ultralaserdeluxe/gloria/dokumentation/designspecifikation/tex/designspecifikation-kopplingsschema-sensorenhet.tex

\section{Kopplingsschema över sensorenhet}

\begin{figure}[h]
\center
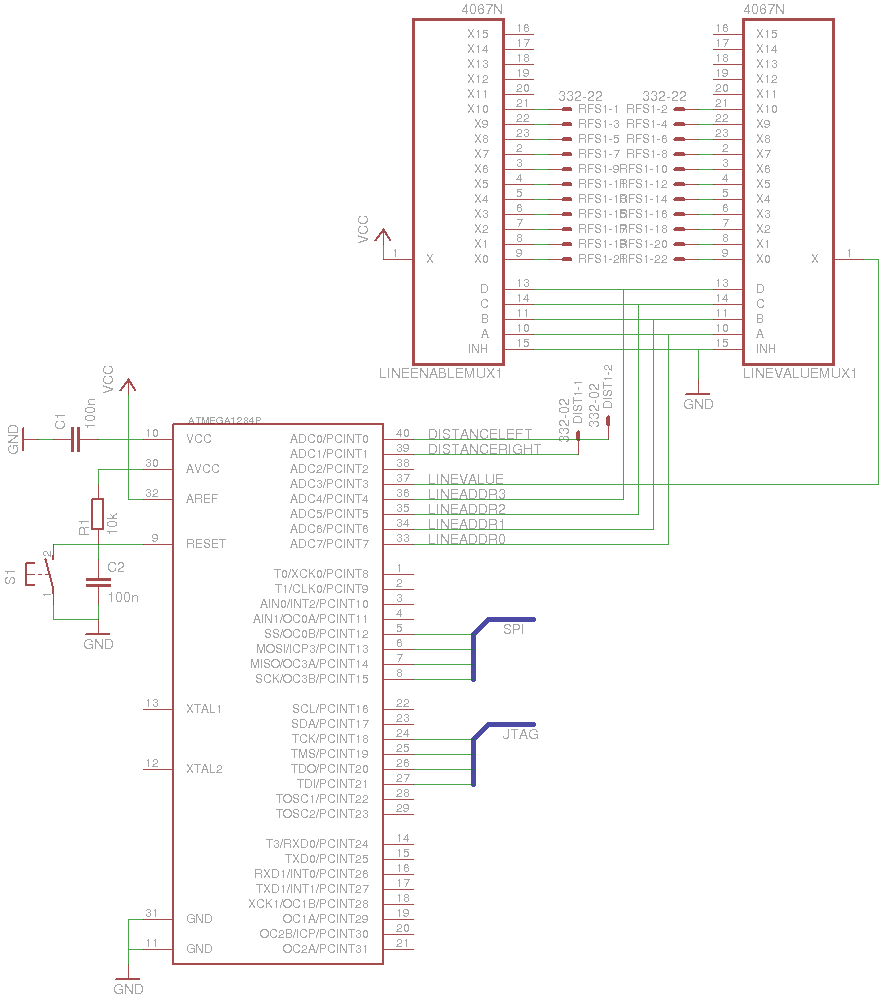
[picture p2: dokumentation/designspecifikation/grafik/kopplingsschema-sensorenhet.png]

\caption{Kopplingsschema över sensorenhet}
\end{figure}

Signalerna RFS går till reflexsensormodulen. Jämna nummer är utsignaler från fototransistorerna. Udda är enablesignaler till lysdioderna. DISTANCELEFT och DISTANCERIGHT är utsignalerna från avståndssensorerna. LINEADDR-signalerna kontrollerar vilken lysdiod i reflexsensormodulen som är aktiv. SPI-bussen ansluts till huvudenheten. JTAG-bussen kopplas till JTAG ICE-3.
