ultralaserdeluxe/gloria/dokumentation/designspecifikation/tex/designspecifikation-kopplingsschema-styrenhet.tex

\section{Kopplingsschema över styrenhet}

\begin{figure}[h]
\center
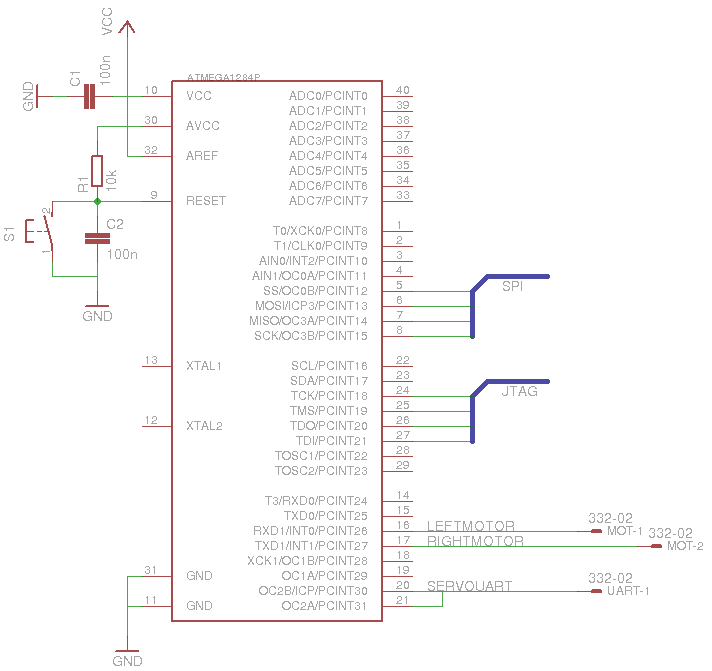
[picture p3: dokumentation/designspecifikation/grafik/kopplingsschema-styrenhet.png]

\caption{Kopplingsschema över styrenhet}
\end{figure}

LEFTMOTOR och RIGHTMOTOR kopplas till motorernas styrportar. SERVOUART kopplas till DATA-porten på armens första servo. SPI-bussen ansluts till huvudenheten. JTAG-bussen kopplas till JTAG ICE-3.
