ultralaserdeluxe/gloria/dokumentation/designspecifikation/tex/designspecifikation-sensorenhet.tex

%\documentclass[a4paper,11pt]{article}
%\usepackage[a4paper]{}
%\usepackage[utf8]{inputenc}
%\usepackage{listings}
%\usepackage{graphicx}
%\begin{document}

\section{Sensorenhet}
Sensorenheten har till uppgift att läsa in data från robotens sensorer, tolka den och vidarebefodra den till huvudenheten. En reflexsensormodul används för att roboten skall kunna hålla sig på banan. För att kunna detektera paket kommer roboten ha en avståndssensor på vardera sida. \\

\begin{figure}[h]
\center
\scalebox{0.9}{\input{grafik/sensorenhet-blockschema.tex}}
\caption{Blockschema över sensorenheten}
\end{figure}

\subsection{Reflexsensormodul}
Reflexsensormodulen består av 11 reflexsensorer. En reflexsensor består av en lysdiod och en fototransistor. Fototransistorn har ett analogt utvärde mellan 0 och 5V beroende på hur mycket ljus som fångas upp. Genom att sätta enable för en lysdiod till 1 och sedan läsa av den tillhörande fototransistorn kan vi avgöra om underlaget är ljust eller mörkt. Fototransistorn läses av med en AD-omvandling på AVRen. Detta görs för varje reflexsensor och på så sätt kan vi detektera tejpens position under sensorn eftersom tejpen banan består av får förutsättas ha en annan färg än golvet. Eftersom AVRen har ett begränsat antal pinnar med AD-omvandling, muxar vi fototransistorernas utgångar till en enda pinne på AVRen. Då vi inte vill ha mer än en lysdiod igång samtidigt kommer vi använda ytterligare en mux för att styra en enablesignal till den lysdiod vi vill använda, övriga kommer vara avslagna.

\subsubsection{Kalibrering}
Beroende på vilket underlag roboten arbetar på kommer värdena för golv och tejp att variera. Vi behöver därför kunna kalibrera sensorn för att sätta standardvärden. Detta kommer ske på ett sådant sätt att vi först låter roboten titta på bara golvet och sedan en bit tejp. Vi sparar de värden vi får under dessa testfall och använder dem som referens när vi ska detektera golv eller tejp.

\subsection{Avståndssensor}
För att kunna detektera paket kommer roboten ha en avståndssensor på höger respektive vänster sida. Dessa kommer vara av typen GP2D120 och använder IR för att generera en analog signal. Denna signal läses av med en AD-omvandling på AVRen. Då sensorns utsignal är olinjär kommer vi under utveckligsfasen ta fram en tabell med närmevärden för olika distanser. Utsignalen jämförs med denna tabell för att estimera det uppmätta avståndet till ett föremål.

\subsection{Mjukvara}
Sensorenheten kör kontinuerligt en loop där den läser och lagrar data från sensorerna. Då huvudenheten skickar en instruktion till sensorenheten körs en avbrottsrutin där instruktionen tolkas och utförs. Antingen kalibreras sensorerna eller så returnerar sensorenheten data för den adresserade sensorn.

\subsection{Komponenter}
Följande komponenter är nödvändiga för konstruktion av sensorenheten. \\

\begin{tabularx}{\textwidth}{| l | X |}
	\hline
	{\textbf{Komponent}} & {\textbf{Tillgänglighet}} \\\hline
	{En AVR av typ Atmega1284} & {Tillgänglig} \\\hline
	{En JTAG Ice 3} & {Tillgänglig} \\\hline
	{En Reflexsensormodul} & {Tillgänglig} \\\hline
	{Två muxar av typ MC14067B} & {Tillgängliga} \\\hline
	{Två avsåndssensorer av typ GP2D120} & {Tillgängliga} \\\hline
	{En avstudsad tryckknapp} & {Tillgänglig} \\\hline
\end{tabularx}
