ultralaserdeluxe/gloria/dokumentation/designspecifikation/tex/designspecifikation-styrenhet.tex

\section{Styrenhet}
Styrenheten har till uppgift att driva de motorer som driver hjulen och de servon som styr armen. Styrenheten består av en AVR av typ Atmega1284, två motorpar och en robotarm av typ Trossenrobotics Reactor\cite{trossenarm}. AVRen är ansluten till huvudenheten med en SPI-buss och en busy-pinne. Instruktioner från huvudenheten fås enligt protokoll definierat i sektion \ref{protokoll:pc-motor}.

\begin{figure}[H]
\center
\input{grafik/styrenhet-blockschema.tex}
\caption{Blockschema över styrenheten}
\end{figure}

\subsection{Framdrivning}

Styrenheten innehåller två motorpar. De är anslutna med två PWM-signaler till AVRen, en till höger respektive vänster hjulpar. Från huvudenheten får styrenheten önskad hastighet på vardera hjulpar, vilka den applicerar och har så möjlighet att styra roboten framåt, bakåt, höger och vänster. Styrenheten är ansvarig för att i mjukvara implementera acceleration av motorerna så att roboten rör sig med jämna och mjuka rörelser.

\subsection{Robotarm}

Robotarmen består av 7 servon av modell AX12-A\cite{servo}. De är anslutna till AVRen med en UART-buss. Dessa servon styrs genom att en målvinkel sätts (0-1023) med möjlighet att ändra hastighet, vridmoment och styra av/på. Från huvudenheten får styrenheten målvinklar för varje enskild led. Styrenheten är ansvarig för att se till att parallella servon körs synkroniserat för att inte slita sönder varandra. Styrenheten är också ansvarig för att servona accelerar och bromsar något i sina rörelser för att robotarmen skall röra sig mjukt och utan ryck. Så länge robotarmen är i rörelse sätts en busy-flagga. Den låter huvudenheten utföra köade instruktioner för robotarmen så snart som det är möjligt.

\subsection{Mjukvara}

Mjukvaran på styrenheten kommer i första hand att vara avbrottsstyrd. Figur \ref{designspec:motor-interrupt-figure} illustrerar programflödet för avbrott. Vid instruktioner för att uppdatera målposition eller hastighet kommer enheten lägga den i en kö. När enheten ombes utföra alla instruktioner kommer den gå igenom kön och uppdatera målpositioner och hastigheter på servon och motorer enligt tidigare inkomna instruktioner. \\
När AVRen inte är upptagen med avbrott körs en loop där alla servons hastighet och position läses av, jämförs med dess målposition och uppdateras med en ny hastighet. Figur \ref{designspec:motor-main-figure} illustrerar programflödet. Detta ger robotarmen jämna och mjuka rörelser. \\

\begin{figure}[H]
\centering
\begin{minipage}[b]{.5\linewidth}
\centering
\scalebox{0.7}{\input{grafik/styrenhet-avbrott-flode}}
\subcaption{Flödesschema för avbrottsrutin}\label{designspec:motor-interrupt-figure}
\end{minipage}%
\begin{minipage}[b]{.5\linewidth}
\centering
\scalebox{0.6}{\input{grafik/styrenhet-main-flode}}
\subcaption{Flödesschema för mainloop}\label{designspec:motor-main-figure}
\end{minipage}
\caption{Styrenhetens mjukvara}\label{fig:1}
\end{figure}

\subsection{Komponenter}
Följande komponenter är nödvändiga för konstruktion av styrenheten. \\
\begin{tabularx}{\textwidth}{| l | X |}
	\hline
	{\textbf{Komponent}} & {\textbf{Tillgänglighet}} \\\hline
	{Två hjulpar} & {Tillgängliga} \\\hline
	{En AVR av typ Atmega1284} & {Tillgänglig} \\\hline
	{En Trossenrobotics Reactor} & {Tillgänglig} \\\hline
	{En JTAG Ice 3} & {Tillgänglig} \\\hline
	{En avstudsad tryckknapp} & {Tillgänglig} \\\hline
\end{tabularx}
