ultralaserdeluxe/gloria/dokumentation/designspecifikation/tex/designspecifikation-referenser.tex

\begin{thebibliography}{9}
\bibitem{handledare} Johansson, Peter, handledare i kursen TSEA29, Linköping, 2014-10-08 (Möte).
\bibitem{nivaomvandlare} \url{http://www.electrokit.com/nivaomvandlare-8-kanaler.50717}, information hämtad 2014-10-13
\bibitem{servo} \url{http://support.robotis.com/en/techsupport_eng.htm#product/dynamixel/ax_series/dxl_ax_actuator.htm}, information hämtad 2014-10-24
\bibitem{trossenarm} \url{http://www.trossenrobotics.com/p/phantomx-ax-12-reactor-robot-arm.aspx}, information hämtad 2014-10-24
\end{thebibliography}
