ultralaserdeluxe/gloria/Dokumentation/Kravspecifikation/Kravspec03.tex

\section{Huvudmodul}

\subsection{Inledande beskrivning av huvudmodul}
Huvudmodulen utför alla nödvändiga beräkningar med data från undermodulerna. Huvudmodulen fattar beslut om någonting ska göras och skickar kommandon til undermodulerna om den är i autonomt läge, är den i manuellt läga fås kommandon från användaren. I båda lägena ska data skickas tillbaka till användaren.

\subsection{Gränssnitt}
\begin{LIPSkravlista}
\LIPSkrav{Orginal}{Huvudmodulen skall kunna skicka och ta emot nödvändiga data från de övriga modulerna}{1}
\end{LIPSkravlista}

\subsection{Funktionella krav för huvudmodul}	
\begin{LIPSkravlista}
\LIPSkrav{Orginal}{Motorer och servon skall regleras smidigt och utan ryck}{1}
\end{LIPSkravlista}
