ultralaserdeluxe/gloria/dokumentation/tekniskdokumentation/tex/tekdok-teori.tex

\section{Teori}
I projektet ingår främst två större teoretiska beräkningsmoment. Vi måste reglera utdatan till motorerna för att roboten skall följa linjen. Vidare vill vi kunna använda enklare koordinater för att tala om vart i rummet armen befinner sig, och vi behöver således kunna konvertera $(x,y,z)$-koordinater till vinklar för armens axlar.

\subsection{Reglering}
För att följa banan måste vi reglera motorernas hastighet. Vi gör detta genom att beräkna ett fel och ändra motorernas hastighet proportionellt mot detta. Felet beräknas genom att vi i varje iteration beräknar vart tejpen befinner sig längs den främre linjesensorn. För att göra detta multiplicerar vi linjesensorvärdena med vikter, dividerar med summan av linjesensorvärdena och subtraherar sedan medianvärdet, vilket i det här fallet är $6$. Vi får ekvation \ref{eq1}.

\begin{equation} \label{eq1}
	Q_{fel}=6-\frac{\sum_{i=1}^{11}S_{n}*n}{\sum_{i=1}^{11}S_n}
\end{equation}

För att beräkna utsignalen använder vi felet $Q_{fel}$ och förändringen jämfört med förra iterationen ${\Delta}Q_{fel}$ tillsammans med konstanterna $P$ och $D$. Vi vet från avsnitt \ref{huvud-regulator} att regleringen körs med en uppdateringsfrekvens på 50Hz.

\begin{equation} \label{eq2}
	Q_{out}=(P*Q_{fel}+D*{\Delta}Q_{fel})*freq
\end{equation}

$Q_{out}$ i ekvationen ovan är den utsignal som används för att beräkna motorernas nya hastigheter.

\subsection{Styrning av arm}
Omvandlingen från $(x,y,z)$-koordinater till vinklar för armens servon sker på huvudenheten. På huvudenheten finns en pythonmodul \texttt{arm.py} som implementerar beräkningarna som beskrivs nedan. Den används i tre steg.
\begin{enumerate}
	\item Skapa en instans av \texttt{robotArm} som är en klass i \texttt{arm.py}.
	\item Använd funktionen \texttt{setAll} som tar in en lista som argument med följande innehåll \newline \texttt{[x,y,z,gripperAngle,gripperRotationsOffset,gripper]}.
	\item Använd funktionen \texttt{getServoValues} som returnerar en lista med alla servons vinklar i form av 10-bitars heltal.
\end{enumerate}

\texttt{GripperAngle} är gripklons vinkel mot marken, \texttt{gripperRotationsOffset} är en offset på gripklons vinkel i förhållande till leden som gripklon är fäst i och \texttt{gripper} är hur mycket gripklon klämmer.

I listan som returneras är första värdet armens bas, det andra är $A1$, det tredje är $A2$, det fjärde $A3$, det femte klons rotation och det sjätte klons grepp.

\begin{figure}[h!]
	\centerline{\input{grafik/huvud-armkoordinatsystem}}
	\caption{Armens koordinatsystem i förhållande till roboten. Upp är robotens färdriktning}
\end{figure}

\begin{figure}[h!]
	\centerline{\input{grafik/huvud-armvinklar}}
	\caption{Armens vinklar}
\end{figure}

Omvandlingen sker på följande sätt där \texttt{gripperRotationOffset} och \texttt{gripper} ignoreras. Antag att roboten startar i $(X,Y,Z,GR)=(0,0,0,\pi/2)$.
Där $GR$(GripRadian) är vilken vinkel gripklon har till $z$-axeln.\newline
Vi omvandlar våra rum-koordinater till en vinkel och plankoordinater $X,Y,Z,GR\rightarrow A,W,Z,GR$. Där $A$ är armens vinkel mot positiva $x$-axeln och $W$ är armens utsträckning.
$$A=tan^{-1}(\dfrac{Y}{X}) $$
$$W=\sqrt{X^2+Y^2}$$
Genom denna omvandlingen så kan vi göra om detta till ett 2-dimensionellt problem istället för ett 3-dimensionellt problem. Vi får in $X$,$Y$,$Z$,$GR$ och ställer in robotens vinkel mot $x$-axelns positiva del och sedan ser vi till att roboten bara har rätt utsträckning och höjd.
$$P_4=(W,Z)$$
$$P_0=(0,0)$$
$$W_2=W-cos(GR)*L_3$$
$$Z_2=Z-sin(GR)*L_3$$
$$H_L=\sqrt{W_2^2+Z_2^2}$$
$$H_A=tan^{-1}(\dfrac{Z_2}{W_2})$$
Cosinussatsen ger:
$$A_1=cos^{-1}(\dfrac{L_1^2+H_L^2-L_2^2}{2*L_1*H_L})+H_A$$
$$W_1=cos(A_1)*L_1$$
$$Z_1=sin(A_1)*L_1$$
$$A_2=tan^{-1}(\dfrac{Z_2-Z_1}{W_2-W_1})-A_1$$
$$A_3=GR-D_2-D_3$$

Då är alla vinklar beräknade men servornas nollpunkter är inte på samma ställen som nollställena i beräkningarna ovanför. Så följande offset ställs in i grader:

\begin{itemize}
	\item $A0=A0+60$
	\item $A1=240-A1$
	\item $A2=240-A2$
	\item $A3=150-A3$
	\item $A4=240-A0+$\texttt{GripperRotationOffset} (klons rotation beror på basens rotation)
	\item $A5$ har ingen offset
\end{itemize}

Dessa vinklar är nu i grader. Dessa multipliceras nu med $\frac{1024}{360}$ för att omvandla grader till 10-bitars binära tal, dessa avrundas nedåt till heltal och kan nu användas direkt av styrenheten.
