ultralaserdeluxe/gloria/dokumentation/tekniskdokumentation/tex/tekdok-kopplingsschema.tex

\section{Kopplingsschema} \label{kopplingsschema}

På nästkommande sidor följer de kopplingsscheman som beskriver hur hårdvaran i Gloria hänger ihop.

\begin{figure}[h!]
	\centering
	
	\caption{Kopplingsschema styrenhet} \label{kopplingsschema-styrenhet}
\end{figure}

\begin{figure}[h!]
	\centering
	
	\caption{Kopplingsschema sensorenhet} \label{kopplingsschema-sensor}
\end{figure}

\begin{figure}[h!]
	\centering
	
	\caption{Kopplingsschema level-shifters och reset-knapp} \label{kopplingsschema-levelshifter}
\end{figure}

\begin{figure}[h!]
	\centering
	
	\caption{Hur PCBn ser ut} \label{kopplingsschema-pcb}
\end{figure}
