ultralaserdeluxe/gloria/dokumentation/motesprotokoll/tex/protokoll_20141215.tex

\documentclass[titlepage, a4paper]{article}
\input{../../mall/layout.tex}	% Importera generella layout-strukturer
\usepackage{tabularx}

\newcommand{\LIPSdokumenttyp}{Mötesprotokoll}
\newcommand{\LIPSkursnamn}{TSEA29}
\newcommand{\LIPSprojektnamn}{Lagerrobot}
\newcommand{\LIPSprojektgrupp}{Grupp 2}
\newcommand{\LIPSutfardare}{hansn314} % Vem har utfärdat protokollet?

\pagenumbering{roman}	% Sidnumrering

\begin{document}

	\begin{projektmote}{Mötesprotokoll}{2014-12-15}
		% ------------ PARAGRAFER ----------------------
		% Syntax \paragraf{Vi bestämde och kom överens}
		% ----------------------------------------------
		\paragraf{Mötet öppnas.}
		\paragraf{Hannes för protokoll.}
		\paragraf{Närvarande: Martin, Daniel, Dennis, Pål, Yngve och Hannes.}
		\paragraf{Vi går igenom vad som saknas. Främst arm-relaterat såsom smidigare rörelse av arm och nedsättning av paket.}
		\paragraf{Mötet avslutas.}
	\end{projektmote}

	\newpage
	\begin{center}
		\begin{tabularx}{\textwidth}{| p{4mm} | X | p{13.5mm} | X |}
			\hline
			\textbf{Nr} & \textbf{Aktivitet} & \textbf{Ansvar} & \textbf{Status} \\\hline
			% ------------ Aktuella aktiviteter ------------
			% Syntax {Nr} & {Aktivitet} & {Ansvarig} & {Status} \\\hline
			% ----------------------------------------------
			{14} & {Skriva UI för PC} & {DW,MS} & {Martin har börjat skriva ett nytt} \\\hline
			{24} & {Implementera styrlogik} & {DL} & {Klar} \\\hline
			{26} & {Mäta respons från motorer och servon} & {AY} & {Klar} \\\hline
			{35} & {Implementera läsning av sensordata på huvud} & {DL} & {Klar} \\\hline
			{40} & {Implementera smoothing-funktion för servon och motorer} & {DL} & {Ej påbörjad} \\\hline
			{41} & {Implementera paketnedsättningsfunktion} & {PK} & {Påbörjad} \\\hline
			{42} & {Implementera fjärrstyrning från PC} & {DW} & {Klar} \\\hline
			{43} & {Implementera detektion av stoppmarkering} & {} & {Klar} \\\hline
			{44} & {Implementera detektion av paket} & {} & {Klar} \\\hline
			{45} & {Implementera detektion av stationer} & {} & {Klar} \\\hline
			{46} & {Implementera regleringsalgoritm} & {AY, MS} & {Implementerad och fungerar bra, behöver finjusteras} \\\hline
			{49} & {Dokumentation: Teknisk dokumentation} & {HS} & {Påbörjad} \\\hline
			{54} & {Tejpa testbanor} & {DW} & {Klar} \\\hline
		\end{tabularx}
	\end{center}

\end{document}
