ultralaserdeluxe/gloria/dokumentation/kravspecifikation/tex/kravspecifikation-programvara.tex

\section{Programvara för PC}

\subsection{Inledande beskrivning av programvara för PC}
Programvaran skall köras på en PC för att göra det möjligt att styra roboten och visa sensor- och debugdata.

\subsection{Gränssnitt}
\begin{LIPSkravlista}
\LIPSkrav{2014-09-12}{Datorn skall kommunicera trådlöst med roboten}{1}
\end{LIPSkravlista}

\subsection{Funktionella krav på programvara för PC}
\begin{LIPSkravlista}
\LIPSkrav{2014-09-12}{Datorn skall kunna skicka följande kommandon: fram, fram vänster, fram höger, back, stopp och kalibrering}{1}
\LIPSkrav{2014-12-08}{Datorn skall kunna skicka kommandon för att styra armens samtliga servon}{1}
\LIPSkrav{Orginal}{Programvaran skall visa sensor- och debugdata}{1}
\end{LIPSkravlista}
