ultralaserdeluxe/gloria/dokumentation/kravspecifikation/tex/kravspecifikation-sensormodul.tex

\section{Sensormodul}
\subsection{Inledande beskrivning av sensormodul}
Sensormodulen skall sköta sensordata för linjeföljare, avståndsmätare för detektering av objekt samt eventuella andra sensorer som kan behövas.

\subsection{Gränssnitt}
\begin{LIPSkravlista}
\LIPSkrav{2014-09-12}{Sensormodulen skall ta emot kommandon från huvudmodulen}{1}
\LIPSkrav{2014-09-12}{Sensormodulen skall skicka sensordata till huvudmodulen}{1}
\end{LIPSkravlista}

\subsection{Funktionella krav för sensormodul}
\begin{LIPSkravlista}
\addtocounter{LIPSkravnummer}{1} % Hade krav
\LIPSkrav{Orginal}{Sensorer skall kunna detektera banan}{1}
\LIPSkrav{2014-09-16}{Sensorer skall kunna detektera ett paket}{1}
\LIPSkrav{Orginal}{Sensorer skall kunna identifiera RFID}{2}
\end{LIPSkravlista}
