ultralaserdeluxe/gloria/dokumentation/kravspecifikation/tex/kravspecifikation-styrmodul.tex

\section{Styrmodul}

\subsection{Inledande beskrivning av motormodul}
Styrmodulen skall sköta framdrivningen av roboten samt sköta de servon som styr robotarmen.

\subsection{Gränssnitt}
\begin{LIPSkravlista}
\LIPSkrav{2014-09-12}{Styrmodulen skall ta emot kommandon från huvudmodulen}{1}
\end{LIPSkravlista}

\subsection{Funktionella krav för styrmodul}
\begin{LIPSkravlista}
\LIPSkrav{Orginal}{Styrmodulen skall utföra kommandon från huvudmodulen}{1}
\LIPSkrav{2014-12-08}{Styrmodulen skall justera hjulens hastighet}{1}
\LIPSkrav{Orginal}{Styrmodulen skall reglera hjulens hastighet utifrån sensordata}{2}
\LIPSkrav{2014-09-12}{Styrmodulen skall reglera de servon som styr armen}{1}
\LIPSkrav{Orginal}{Armrörelser skall ske utan uppenbara ryck}{1}
\LIPSkrav{2014-09-12}{Armen skall återgå till ett förutbestämt läge vid ett särskilt givet kommando}{2}
\end{LIPSkravlista}
