ultralaserdeluxe/gloria/dokumentation/motesprotokoll/tex/protokoll_20141208.tex

\documentclass[titlepage, a4paper]{article}
\input{../mall/layout.tex}	% Importera generella layout-strukturer
\usepackage{tabularx}

\newcommand{\LIPSdokumenttyp}{Mötesprotokoll}
\newcommand{\LIPSkursnamn}{TSEA29}
\newcommand{\LIPSprojektnamn}{Lagerrobot}
\newcommand{\LIPSprojektgrupp}{Grupp 2}
\newcommand{\LIPSutfardare}{hansn314} % Vem har utfärdat protokollet?

\pagenumbering{roman}	% Sidnumrering

\begin{document}

	\begin{projektmote}{Mötesprotokoll}{2014-12-08}
		% ------------ PARAGRAFER ----------------------
		% Syntax \paragraf{Vi bestämde och kom överens}
		% ----------------------------------------------
		\paragraf{Mötet öppnas.}
		\paragraf{Hannes för protokoll.}
		\paragraf{Närvarande: Martin, Daniel, Dennis, Pål, Yngve och Hannes.}
		\paragraf{Vi går igenom tidsplanen.}
		\paragraf{Vi diskuterar vad som fungerar, vad som inte fungerar och vad som bör göras i veckan.
		\begin{itemize}
			\item{Fixa haspackage-flagga}
			\item{Testa styrlogik}
			\item{Integrera joystick i GUI}
			\item{Merga alla brancher}
		\end{itemize}
		}
		\paragraf{Mötet avslutas.}
	\end{projektmote}

	\newpage
	\begin{center}
		\begin{tabularx}{\textwidth}{| p{4mm} | X | p{13.5mm} | X |}
			\hline
			\textbf{Nr} & \textbf{Aktivitet} & \textbf{Ansvar} & \textbf{Status} \\\hline
			% ------------ Aktuella aktiviteter ------------
			% Syntax {Nr} & {Aktivitet} & {Ansvarig} & {Status} \\\hline
			% ----------------------------------------------
			{14} & {Skriva UI för PC} & {DW} & {En första iteration färdig} \\\hline
			{24} & {Implementera styrlogik} & {DL} & {Påbörjad} \\\hline
			{26} & {Mäta respons från motorer och servon} & {AY} & {Påbörjad} \\\hline
			{28} & {Tolka IR-sensordata} & {PK} & {Påbörjad} \\\hline
			{35} & {Implementera läsning av sensordata på huvud} & {DL} & {Påbörjad} \\\hline
			{40} & {Implementera smoothing-funktion för servon och motorer} & {DL} & {Ej påbörjad} \\\hline
			{41} & {Implementera paketnedsättningsfunktion} & {PK} & {Ej påbörjad, försenad} \\\hline
			{42} & {Implementera fjärrstyrning från PC} & {DW} & {Påbörjad} \\\hline
			{43} & {Implementera detektion av stoppmarkering} & {} & {påbörjad} \\\hline
			{44} & {Implementera detektion av paket} & {} & {Påbörjad} \\\hline
			{45} & {Implementera detektion av stationer} & {} & {Påbörjad} \\\hline
			{46} & {Implementera regleringsalgoritm} & {AY, MS} & {Implementerad och fungerar bra, behöver finjusteras} \\\hline
			{49} & {Dokumentation: Teknisk dokumentation} & {HS} & {Påbörjad} \\\hline
			{54} & {Tejpa testbanor} & {DW} & {Klar} \\\hline
		\end{tabularx}
	\end{center}

\end{document}
