ultralaserdeluxe/gloria/dokumentation/kravspecifikation/tex/kravspecifikation-huvudmodul.tex

\section{Huvudmodul}

\subsection{Inledande beskrivning av huvudmodul}
Huvudmodulen skall utföra beräkningar nödvändiga för robotens funktion. Huvudmodulen fattar beslut om någonting skall göras och skickar kommandon till undermodulerna om den är i autonomt läge, är den i manuellt läge fås kommandon från användaren. I båda lägena skall data skickas tillbaka till användaren.

\subsection{Gränssnitt}
\begin{LIPSkravlista}
\LIPSkrav{2014-09-12}{Huvudmodulen skall skicka kommandon till sensormodulen}{1}
\LIPSkrav{2014-09-12}{Huvudmodulen skall ta emot sensordata från sensormodulen}{1}
\LIPSkrav{2014-09-12}{Huvudmodulen skall skicka kommandon till styrmodulen}{1}
\LIPSkrav{2014-09-12}{Huvudmodulen skall skicka sensordata och driftinformation till datorn}{1}
\LIPSkrav{2014-09-12}{Huvudmodulen skall ta emot kommandon från datorn}{1}
\end{LIPSkravlista}

\subsection{Funktionella krav för huvudmodul}	
\begin{LIPSkravlista}
\LIPSkrav{Orginal}{Motorer och servon skall regleras smidigt och utan ryck}{1}
\LIPSkrav{Orginal}{Roboten skall följa banan utan att sick-sacka sig fram}{1}
\end{LIPSkravlista}
