ultralaserdeluxe/gloria/dokumentation/kravspecifikation/tex/kravspecifikation-kommunikationsmodul.tex

\section{Kommunikationsmodul}

\subsection{Inledande beskrivning av kommunikationsmodul}
Kommunikationsmodulen är länken som gör kommunikation mellan huvudmodulen och PCn möjlig.

\subsection{Gränssnitt}
\begin{LIPSkravlista}
\LIPSkrav{2014-09-12}{Kommunikationsmodulen skall ta emot kommandon från PC-mmodulen}{1}
\LIPSkrav{2014-09-12}{Kommunikationsmodulen skall skicka kommandon till huvudmodulen}{1}
\LIPSkrav{2014-09-12}{Kommunikationsmodulen skall ta emot sensordata och driftinformation från huvudmodulen}{1}
\LIPSkrav{2014-09-12}{Kommunikationsmodulen skall skicka sensordata och driftinformation till PC-modulen}{1}
\end{LIPSkravlista}
