ultralaserdeluxe/gloria/dokumentation/kravspecifikation/tex/kravspecifikation-motormodul.tex

\section{Motormodul}

\subsection{Inledande beskrivning av motormodul}
Motormodulen sköter framdrivningen av roboten.

\subsection{Gränssnitt}
\begin{LIPSkravlista}
\LIPSkrav{2014-09-12}{Motormodulen skall ta emot kommandon från huvudmodulen}{1}
\end{LIPSkravlista}

\subsection{Funktionella krav för motormodul}
\begin{LIPSkravlista}
\LIPSkrav{Orginal}{Motormodulen skall reglera hjulens hastighet}{1}
\LIPSkrav{Orginal}{Motormodulen skall utföra kommandon från huvudmodulen}{1}
\LIPSkrav{Orginal}{Motormodulen skall reglera hjulens hastighet utifrån sensordata}{2}
\end{LIPSkravlista}
