ultralaserdeluxe/gloria/dokumentation/motesprotokoll/protokoll_20141201.pdf

Utfärdat av hansn314
2 december 2014

# Mötesprotokoll

2014-12-01

- §1. Mötet öppnas.
- §2. Närvarande: Martin, Daniel, Dennis, Pål, Yngve och Hannes
- §3. Vi går igenom bordlagda frågor angående statusrapporten:

– Hur mycket tid har ni kvar av era budgeterade timmar?
Vi har 354 budgeterade timmar kvar att lägga på projektet.

– Hur många timmar har respektive projektmedlem kvar att leverera och hur ska dessa timmar fördelas över de kvarvarande veckorna? Redovisa i en tabell i statusrapporten hur många timmar detta blir per person och vecka. Redovisa också vilka aktiviteter som respektive person ska arbeta med.

Vem | Sammanlagt | v.49 | v.50 | v.51 | Aktiviteter
Pål | 63 | 25 | 25 | 13 | 48,41,44,53,50,42
Hannes | 46 | 18 | 18 | 10 | 48,49,26,45
Martin | 55 | 20 | 20 | 15 | 48,38,39,46,53
Dennis | 72 | 27 | 27 | 18 | 48,24,40,44,47,53
Yngve | 53 | 20 | 20 | 13 | 48,46,43,49
Daniel | 67 | 25 | 25 | 17 | 48,47,42,51,52
- §4. Mötet avslutas.

TSEA29
Mötesprotokoll
i | Grupp 2 Lagerrobot

Utfärdat av hansn314
2 december 2014

## Aktuella aktiviteter

Nr | Aktivitet | Ansvar | Status
14 | Skriva UI för PC | DW | En första iteration färdig
17 | Implementera styrning av servon | HS | Klarr
24 | Implementera styrlogik | DL | Påbörjad
26 | Mäta respons från motorer och servon | AY | Ej påbörjad, Försenad
28 | Tolka IR-sensordata | PK | Påbörjad
33 | Testa styra servon från huvud | AY | Klar
35 | Implementera läsning av sensordata på huvud | DL | Påbörjad
38 | Implementera och testa X,Y,Z till ser-vovinkel konvertering | MS, HS | Ej testat, annars klart
39 | Implementera och testa gränser för armen | MS | Ej påbörjad, försenad
40 | Implementera smoothing-funktion för servon och motorer | DL | Ej påbörjad
41 | Implementera paket-nedsättningsfunktion | PK | Ej påbörjad, försenad
42 | Implementera fjärrstyrning från PC | DW | Påbörjad
43 | Implementera detektion av stoppmar-kering | | påbörjad
44 | Implementera detektion av paket | | Påbörjad
45 | Implementera detektion av stationer | | Påbörjad
46 | Implementera regleringsalgoritm | AY, MS | Implementerad, behöver finjusteras
54 | Tejpa testbanor | DW | Ej påbörjad

TSEA29
Mötesprotokoll
ii | Grupp 2 Lagerrobot
