ultralaserdeluxe/gloria/dokumentation/tidsplan/tidsplan_v1.0.pdf

Projekt: | Lagerrobot
Projektgrupp: | 2 | Datum: | 2014-10-02 | Granskad:
Beställare: | Tomas Svensson | Version: | 1,0
Kurs: | Konstruktion med mikrodatorer TSEA29 | Utfärdare: | Tomas Svensson
AKTIVITETER | TID | VEM | TIDPLAN (när), veckonummer | SUMMA
Nr | Beskrivning | Beroenden | timmar | Initialer | 40 | 41 | 42 | 43 | 44 | 45 | 46 | 47 | 48 | 49 | 50 | 51
1 | Implementera buss mellan huvud och styr | | 16 | AY,DL | | | | Tentaperiod | Tentaperiod | 16 | | | | | | | 16
2 | Koppla ihop huvud och styr | | 4 | AY | | | | Tentaperiod | Tentaperiod | 4 | | | | | | | 4
3 | Implementera buss mellan huvud och sensor | | 16 | HS,DL | | | | Tentaperiod | Tentaperiod | 16 | | | | | | | 16
4 | Koppla ihop huvud och sensor | | 4 | AY | | | | Tentaperiod | Tentaperiod | 4 | | | | | | | 4
5 | Sätta upp utvecklingsmiljö för AVR | | 8 | MS | | | | Tentaperiod | Tentaperiod | 8 | | | | | | | 8
6 | Installera mjukvara på huvud (OS, Python, drivare) | | 10 | MS,PK | | | | Tentaperiod | Tentaperiod | 10 | | | | | | | 10
7 | Python-modul på PC för att skicka/ta emot data från huvud | | 16 | DW | | | | Tentaperiod | Tentaperiod | 8 | 8 | | | | | | 16
8 | Koppla in linjesensorer på sensorenheten | | 10 | AY | | | | Tentaperiod | Tentaperiod | 10 | | | | | | | 10
9 | Koppla in IR-sensor på sensorenheten | | 2 | AY | | | | Tentaperiod | Tentaperiod | 2 | | | | | | | 2
10 | Koppla in motorer på styr | | 2 | AY | | | | Tentaperiod | Tentaperiod | 2 | | | | | | | 2
11 | Koppla in servorn på styr | | 2 | AY | | | | Tentaperiod | Tentaperiod | 2 | | | | | | | 2
12 | Upprätta BT förbindelse mellan huvud och PC | 6 | 10 | MS | | | | Tentaperiod | Tentaperiod | 10 | | | | | | | 10
13 | Sätta upp utvecklingsmiljö för BeagleBoard (wifi) | 6 | 4 | MS | | | | Tentaperiod | Tentaperiod | 4 | | | | | | | 4
14 | Skriva UI för PC | 7 | 20 | DW | | | | Tentaperiod | Tentaperiod | | | | | | 20 | | 20
15 | Implementera och testa muxning för linjesensor | 8 | 8 | PK | | | | Tentaperiod | Tentaperiod | | 8 | | | | | | 8
16 | Implementera styrning av motorer | 10 | 8 | PK | | | | Tentaperiod | Tentaperiod | | 8 | | | | | | 8
17 | Implementera styrning av servon | 11 | 20 | HS | | | | Tentaperiod | Tentaperiod | | 20 | | | | | | 20
18 | Testa och felsöka buss mellan huvud och styr | 1;2;13 | 16 | HS | | | | Tentaperiod | Tentaperiod | | 16 | | | | | | 16
19 | Testa och felsöka buss mellan huvud och sensor | 3;4;13 | 16 | AY | | | | Tentaperiod | Tentaperiod | | 16 | | | | | | 16
24 | Implementera styrlogik | 13 | 40 | DL,AY | | | | Tentaperiod | Tentaperiod | | | | | 16 | 24 | | 40
25 | Implementera läsning av sensorer | 15;9 | 16 | HS | | | | Tentaperiod | Tentaperiod | | | 16 | | | | | 16
26 | Mäta respons från motorer och servon | 16;17 | 8 | AY | | | | Tentaperiod | Tentaperiod | | | 8 | | | | | 8
27 | Implementera tolkning och utförande av kommandon från PC på huvud | 7;19 | 12 | DL | | | | Tentaperiod | Tentaperiod | | | 12 | | | | | 12
28 | Tolka IR-sensordata | 25 | 8 | PK | | | | Tentaperiod | Tentaperiod | | | 8 | | | | | 8
29 | Implementera kalibreringsfunktion | 37 | 20 | DL | | | | Tentaperiod | Tentaperiod | | 4 | 4 | 12 | | | | 20
30 | Implementera tolkning och utförande av kommandon från huvud på sensorenheten | 19;25 | 16 | HS | | | | Tentaperiod | Tentaperiod | | | 16 | | | | | 16
31 | Testa styra servon från styrenheten | 26 | 8 | PK | | | | Tentaperiod | Tentaperiod | | 8 | | | | | | 8
32 | Testa styra motorer från styrenheten | 26 | 8 | DW | | | | Tentaperiod | Tentaperiod | | 8 | | | | | | 8
33 | Testa styra servon från huvud | 18;31 | 8 | DL | | | | Tentaperiod | Tentaperiod | | | 8 | | | | | 8
34 | Testa styra motorer från huvud | 18;32 | 8 | DL | | | | Tentaperiod | Tentaperiod | | | 8 | | | | | 8
35 | Implementera läsning av sensordata på huvud | 19;30 | 8 | DL | | | | Tentaperiod | Tentaperiod | | | 8 | | | | | 8
37 | Skriva testprogram för linjesensor sensorenheten | 25 | 8 | PK | | | | Tentaperiod | Tentaperiod | | | 8 | | | | | 8
38 | Implementera och testa X,Y,Z till servorvinkel konvertering | 31 | 32 | MS,HS | | | | Tentaperiod | Tentaperiod | | | | 20 | 12 | | | 32
39 | Implementera och testa gränser för armen | 31 | 24 | MS | | | | Tentaperiod | Tentaperiod | | | | 24 | | | | 24
40 | Implementera smoothing-funktion för servorn och motorer | 32 | 16 | DL | | | | Tentaperiod | Tentaperiod | | | | | 8 | 8 | | 16
41 | Implementera paketnersättningsfunktion | 33 | 16 | PK | | | | Tentaperiod | Tentaperiod | | | | 16 | | | | 16
42 | Implementera fjärrstyrning från PC | 27;33;34;35 | 16 | DW | | | | Tentaperiod | Tentaperiod | | | | 5 | 11 | | | 16
43 | Implementera och testa detektion av stoppmarkering | 35;37 | 16 | AY | | | | Tentaperiod | Tentaperiod | | | | | 16 | | | 16
44 | Implementera och testa detektion av paket | 35;36 | 16 | PK | | | | Tentaperiod | Tentaperiod | | | | | 16 | | | 16
45 | Implementera och testa detektion av stationer | 35;37 | 16 | HS | | | | Tentaperiod | Tentaperiod | | | | | 16 | | | 16
46 | Implementera regleringsalgoritm (linjeföljare) | 34;37 | 40 | AY,MS | | | | Tentaperiod | Tentaperiod | | | | 40 | | | | 40
47 | Testa styrlogik | 43;44;45;46 | 40 | DL,DW | | | | Tentaperiod | Tentaperiod | | | | | | 8 | 32 | 40
48 | Möten | | 72 | alla | | | | Tentaperiod | Tentaperiod | 10 | 10 | 10 | 10 | 10 | 10 | 12 | 72
49 | Dokumentation: Teknisk dokumentation | | 32 | HS | | | | Tentaperiod | Tentaperiod | | | | | 8 | 24 | | 32
50 | Dokumentation: Tidsrapport | | 10 | PK | 1 | 1 | 1 | Tentaperiod | Tentaperiod | 1 | 1 | 1 | 1 | 1 | 1 | 1 | 10
51 | Dokumentation: Användarhandledning | 8 | DW | Tentaperiod | Tentaperiod | 8 | 8
52 | Dokumentation: Efterstudie | 8 | DW | Tentaperiod | Tentaperiod | 8 | 8
53 Presentation + PP | 32 PK | Tentaperiod | Tentaperiod | 32 | 32
54 Tejpa testbanor | 3 DW | Tentaperiod | Tentaperiod | 1 | 1 | 1 | 3
55 Dokumentation: Designspecifikation | 100 alla | 33 | 34 | 33 Tentaperiod | Tentaperiod | 100
56 Bufferttid | 103 alla | Tentaperiod | Tentaperiod | 14 | 14 | 15 | 15 | 15 | 15 | 15 | 103
M1 | Milstolpe 1: Fungerande kommunikation mellan huvud-, styr- och sensorenhet | 18;19 | Tentaperiod | Tentaperiod | Fr | 0
M2 | Milstolpe 2: Läs data (driftinfo, sensorvärden) på PC | 35;12;7 | Tentaperiod | Tentaperiod | Fr | 0
M3 | Milstolpe 3: Robotens samtliga motorer och servon kan styras från PC | 33;34;27 | Tentaperiod | Tentaperiod | Fr | 0
M4 | Milstolpe 4: Roboten kan följa en linje autonomt | 33;34;37;46;54 | Tentaperiod | Tentaperiod | Fr | 0
M5 | Milstolpe 5: Robotens arm har full funktionalitet | 38;39;40;42 | Tentaperiod | Tentaperiod | Fr | 0
M6 | Milstolpe 6: Roboten kan stanna på plockstationer och detektera paket | 43;44;45;46;47 | Tentaperiod | Tentaperiod | Fr | 0
M7 | Milstolpe 7: Roboten är tävlingsklar | Tentaperiod | Tentaperiod | Fr | 0
BP2 | Beslutspunkt 2: Godkännande av projektplanering, beslut att starta utförandefasen | To | Tentaperiod | Tentaperiod
BP3 | Beslutspunkt 3: Godkännande av designspecifikation, beslut att fortsätta utförandefasen | Tentaperiod | Tentaperiod | Fr
BP5 | Beslutspunkt 5: Godkännande av produktens funktionalitet, beslut att leverera | Tentaperiod | Tentaperiod | To
BP6 | Beslutspunkt 6: Godkännande av leverans, beslut att upplösa projektgruppen | Tentaperiod | Tentaperiod | Fr
SUMMA | 960 | 34 | 35 | 34 | 0 | 0 | 122 | 122 | 123 | 143 | 129 | 110 | 108 | 960
