ultralaserdeluxe/gloria/dokumentation/tekniskdokumentation/grafik/kopplingsschema-level_shifters.pdf

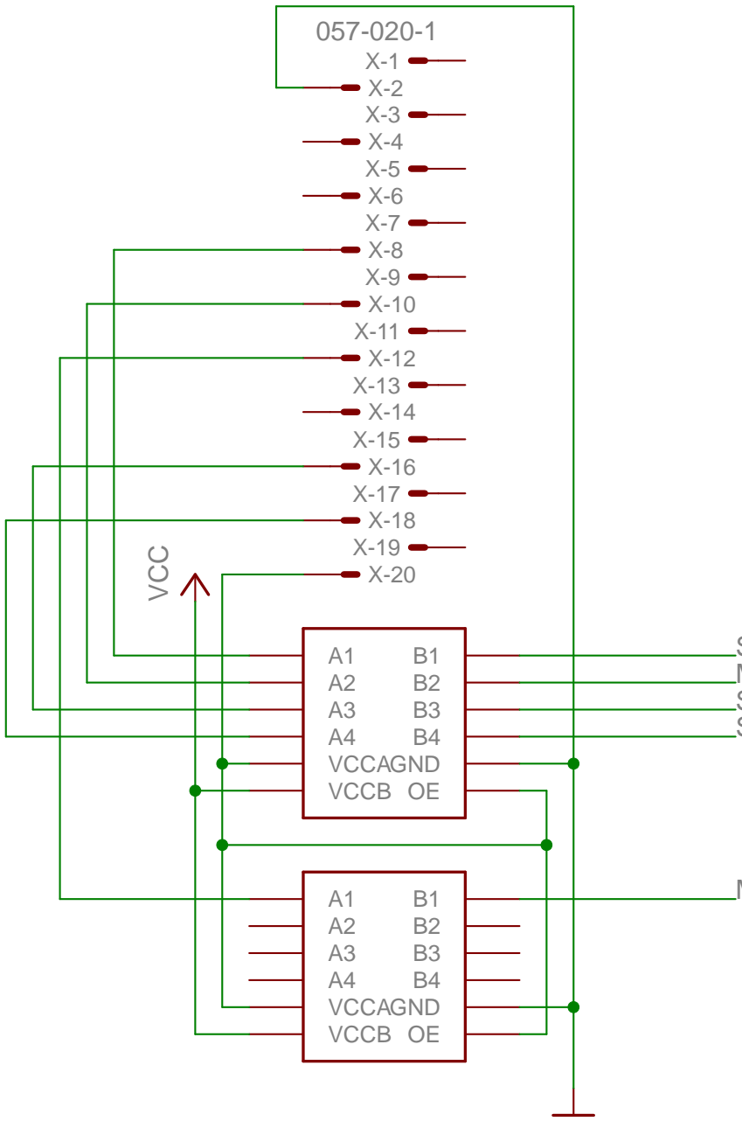
[picture p49: figure]
VCC; VCCA; GND OE; VCCB

### GND

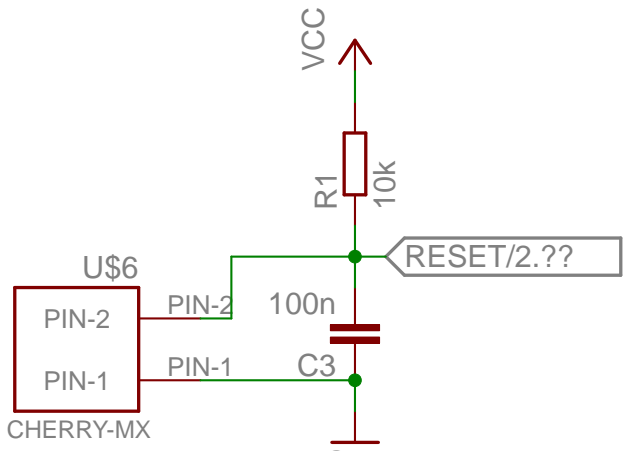
[picture p50: figure]
VCC; CHERRY-MX; PIN-1; PIN-2; RESET/2.??

### GND

### POWER_JACKSLT

### GND

VCC

JP1

### SCK MOSI

SS1
SS0

### MISO
