ultralaserdeluxe/gloria/dokumentation/tekniskdokumentation/tekniskdokumentation.tex

\documentclass[titlepage, a4paper]{article}
\input{../mall/layout.tex}	% Importera generella layout-strukturer

% Information nödvändig för generella layout-strukturer
\newcommand{\LIPSredaktor}{Hannes Snögren}
\newcommand{\LIPSversion}{1.1}
\newcommand{\LIPSdokument}{Teknisk dokumentation}
\newcommand{\LIPSdokumenttyp}{Teknisk dokumentation}
\newcommand{\LIPSgranskatdatum}{2014-12-19}
\newcommand{\LIPSgranskare}{Tomas Svensson}
\newcommand{\LIPSgodkannare}{Tomas Svensson}
\newcommand{\LIPSgodkantdatum}{2014-12-19}
\newcommand{\LIPSkursnamn}{TSEA29}
\newcommand{\LIPSprojektnamn}{Lagerrobot}
\newcommand{\LIPSprojektgrupp}{Grupp 2}
%\newcommand{\LIPSgruppadress}{}
\newcommand{\LIPSartaltermin}{HT2, 2014}
\newcommand{\LIPSgrupphemsida}{http://github.com/ultralaserdeluxe/gloria}
\newcommand{\LIPSkund}{Tomas Svensson}
\newcommand{\LIPSkundkontakt}{Tomas Svensson}
\newcommand{\LIPSkursansvarig}{Tomas Svensson}
\newcommand{\LIPShandledare}{Peter Johansson}
\newcommand{\LIPSfrontpicture}{}

% Dokument-specifika paket
\usepackage{tabularx}
\usepackage{subcaption}
\usepackage{tikz}
\usepackage{mathtools}
\usepackage{url}
\usepackage{dirtree}
\usetikzlibrary{shapes, arrows}

\DeclareGraphicsExtensions{.eps, .pdf}

\pagenumbering{roman}

\begin{document}

\LIPSTitelsida

\begin{LIPSprojektidentitet}
\LIPSgruppmedlem{Pål Kastman}{Projektledare}{0703896295}{palka285@student.liu.se}
\LIPSgruppmedlem{Hannes Snögren}{Dokumentansvarig}{0706265064}{hansn314@student.liu.se}
\LIPSgruppmedlem{Alexander Yngve}{Hårdvaruansvarig}{0762749762}{aleyn573@student.liu.se}
\LIPSgruppmedlem{Martin Söderén}{Mjukvaruansvarig}{0708163241}{marso329@student.liu.se}
\LIPSgruppmedlem{Daniel Wassing}{Leveransansvarig}{0767741110}{danwa223@student.liu.se}
\LIPSgruppmedlem{Dennis Ljung}{Testansvarig}{0708568148}{denlj069@student.liu.se}
\end{LIPSprojektidentitet}

\newpage
\tableofcontents	%Innehållsförteckning
%\listoffigures
%\listoftables

\newpage

\begin{LIPSdokumenthistorik}
\LIPSversionsinfo{0.1}{2014-12-16}{Första utkast}{hansn314}{}
\LIPSversionsinfo{1.0}{2014-12-16}{Första version}{hansn314}{2014-12-19}
\LIPSversionsinfo{1.1}{2014-12-22}{Första revision}{hansn314}{}
\end{LIPSdokumenthistorik}

\newpage
\pagenumbering{arabic}	%Påbörja sidnumrering

% Inledning, översikt osv
\input{tex/tekdok-inledning}
\input{tex/tekdok-produkten}
\input{tex/tekdok-systemet}
\input{tex/tekdok-kommunikation}
\input{tex/tekdok-teori}
\input{tex/tekdok-pcenhet}
\input{tex/tekdok-huvudenhet}
\input{tex/tekdok-styrenhet}
\input{tex/tekdok-sensorenhet}
\input{tex/tekdok-slutsatser}
\newpage
\input{tex/tekdok-referenser}

\newpage
\begin{appendices}

% Bilagor
\input{tex/tekdok-kopplingsschema}

\end{appendices}

\end{document}
