ultralaserdeluxe/gloria/dokumentation/motesprotokoll/motesmall.tex

\documentclass[titlepage, a4paper]{article}
\input{../mall/layout.tex}	% Importera generella layout-strukturer

\newcommand{\LIPSdokumenttyp}{Kravspecifikation}
\newcommand{\LIPSkursnamn}{TSEA29}
\newcommand{\LIPSprojektnamn}{Lagerrobot}
\newcommand{\LIPSprojektgrupp}{Grupp 2}

\pagenumbering{arabic}	%Påbörja sidnumrering

\begin{document}

{\ }\vspace{5mm}

\begin{center}
  \textbf{\Huge Dagordning Mötestyp 1}
\end{center}

\vspace{10mm}

\begin{itemize}
\item{\textsection 1. Mötet öppnas av projektledaren alternativt tillförodnade projektledare.}
\item{\textsection 2. Sekreterare utses. Normalt utses dokumentansvariga.}
\item{\textsection 3. Varje gruppmedlem får några minuter att redogöra för sitt arbetes status.
\begin{itemize}
\item{Hur går arbetet?}
\item{Medlemmen får uppskatta om denne tror att veckans aktiviteter kommer att hinnas med. Behövs ytterligare timmar eller eventuellt en till gruppmedlem tilldelas aktiviteten?}
\item{Är medlemmen sjuk och arbetsuppgiften ligger som beroende hos andra aktiviteter, måste uppgiften isåfall överlämnas till en annan gruppmedlem?}
\item{Är medlemmen redan klar med veckans aktiviteter?}
\end{itemize}
}
\item{\textsection 4. Diskussion och eventuellt problem i \textsection 3.
\begin{itemize}
\item{Ska samliga medlemmar närvara för att diskutera problemen?}
\end{itemize}
}
\item{\textsection 5. Mötet avslutas.}
\end{itemize}

\end{document}
