ultralaserdeluxe/gloria/dokumentation/motesprotokoll/tex/motesmall2.tex

\documentclass[titlepage, a4paper]{article}
\input{../../mall/layout.tex}	% Importera generella layout-strukturer

\newcommand{\LIPSdokumenttyp}{Kravspecifikation}
\newcommand{\LIPSkursnamn}{TSEA29}
\newcommand{\LIPSprojektnamn}{Lagerrobot}
\newcommand{\LIPSprojektgrupp}{Grupp 2}

\pagenumbering{gobble}	%Ingen sidnumrering

\begin{document}

{\ }\vspace{5mm}

\begin{center}
  \textbf{\Huge Dagordning Mötestyp 2}
\end{center}

\vspace{10mm}

\begin{itemize}
\item{\textsection 1. Mötet öppnas av projektledaren alternativt tillförodnade projektledare.}
\item{\textsection 2. Sekreterare utses. Normal utses dokumentansvariga.}
\item{\textsection 3. Genomgång av föregående protokoll där varje medlem granskas genom.
\begin{itemize}
\item{Vad skulle göras?}
\item{Har veckans arbete gjorts?}
\item{Om inte, varför?}
\item{Vad ska göras nästa vecka?}
\item{Känns detta rimligt}
\item{Måste anpassning ske redan i förväg?}
\end{itemize}
}
\item{\textsection 4. Beslut om omplanering tas genom votering. Vid oavgjort avgör projektledaren}
\item{\textsection 5. Har projektledaren fått någon punkt inskickad?}
\item{\textsection 6. Övriga frågor.}
\item{\textsection 7. Mötet avslutas.}
\end{itemize}

\end{document}
