ultralaserdeluxe/gloria/dokumentation/projektplan/tex/projektplan-dokumentplan.tex

\section{Dokumentplan}
Dokumentation listad i tabell \ref{dokumentation:tabell} skall utföras.

\begin{table}[h]
	\centering
		\begin{tabularx}{\textwidth}{| p{22mm} | l | X | p{25mm} | X | l |}
			\hline
			\textbf{Dokument} & \textbf{Ansvarig} & \textbf{Godkänns av} & \textbf{Syfte} & \textbf{Distribue-
  ras till} & \textbf{Färdig datum} \\\hline

			{Systemskiss} & {Daniel} & {Tomas} & {Underlag för Designspecen} & {Gruppen och Tomas} & {2014-10-02} \\\hline
    		{Tidsplan} & {Daniel} & {Tomas}& {Hjälpmedel under projektet} & {Gruppen och Tomas} & {2014-10-02} \\\hline
			{Projektplan} & {Daniel} & {Tomas} & {Hjälpmedel för hur projektet ska utföras} & {Gruppen och Tomas} & {2014-10-02} \\\hline
			{Tidsrapporter} & {Daniel} & {Tomas} & {För att kunna se så alla bidrar} & {Gruppen och Tomas} & {Varje måndag} \\\hline
			{Uppdaterad tidsplan} & {Daniel} & {Tomas} & {Se hur projektet ligger till} & {Gruppen och Tomas} & {Varje måndag} \\\hline
			{Statusrapport för projektet} & {Daniel} & {Tomas} & {Se hur projektet ligger till} & {Gruppen och Tomas} & {Vid begäran} \\\hline
			{Designspec} & {Daniel} & {Peter} & {Underlag för konstruktionen} & {Gruppen och Tomas} & {2014-11-07} \\\hline
            {Teknisk
			dokumentation} & {Daniel} & {Tomas} & {Dokumentera de tekniska lösningarna} & {Gruppen och Tomas} & {2014-12-12} \\\hline
            {Användar-
			handledning} & {Daniel} & {Delges Tomas} & {Manual för användarna} & {Gruppen och Tomas} & {2014-12-12} \\\hline
			{Efterstudie
			dokument} & {Daniel} & {Tomas}& {Reflektera vad som skulle gjorts annorlunda} & {Gruppen och Tomas} & {2014-12-19} \\\hline
		\end{tabularx}
	\caption{Dokumentation.} \label{dokumentation:tabell}
\end{table}
