ultralaserdeluxe/gloria/dokumentation/kravspecifikation/tex/kravspecifikation-armmodul.tex

\section{Armmodul}

\subsection{Inledande beskrivning av armmodul}
Armmodulen skall sköta de servon som styr robotarmen.

\subsection{Gränssnitt}
\begin{LIPSkravlista}
\LIPSkrav{2014-09-12}{Armmodulen skall ta emot kommandon från huvudmodulen}{1}
\end{LIPSkravlista}

\subsection{Funktionella krav för armmodul}
\begin{LIPSkravlista}
\LIPSkrav{Orginal}{Armrörelser skall ske utan uppenbara ryck}{1}
\LIPSkrav{2014-09-12}{Ett kommando skall finnas där armen återgår till ett förutbestämt läge}{2}
\end{LIPSkravlista}
