ultralaserdeluxe/gloria/dokumentation/kodstandard_v1.0.pdf

Utfärdat av hansn314
6 november 2014

# Kodstandard för C

# anno 2014

## 1 Bakgrund

Då yngve drömmer mardrömmar om fula kodfiler och projektet i TSEA29 innebär att många ska jobba på samma C-filer är en gemensam kodstandard nödvändig.

## 2 Funktionsnamn

Funktionsnamn skrivs med gemener, understreck separerar orden. Funktionsnamnen skall vara kompletta, inga onödiga förkortningar. T.ex SP I handler() är okej, usr cnt() är det inte. Mellanslag mellan funktionsnamnet och dess parametrar existerar inte, utan används endast mellan parametrar såsom det andra exemplet visar.

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

## 3 Variabelnamn

Variabelnamn följer samma regler som funktionsnamn, med tillägget att konstanter skrivs med versaler. Om globala variabler nödvändigtvis måste användas, följer de samma regler som vanliga variabler.

i n t l i s t l e n g t h ;
i n t STANDARD SPEED;

## 4 Kommentarer

Alla kommentarer skall vara på engelska. I varje fil skall det finnas en header enligt följande.

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

/∗ Returns the l e n g t h o f a gi v e n word ∗/
i n t w o r d l e n g t h ( un si gned ch a r word )
| Om kod finns mitt i koden, skall det vara på raden ovanför den gällande kodraden. I det fall
att kodraden innehåller tal i hexadecimal eller binär form, må betydelsen av dessa värden skrivas på samma rad.

TSEA29
Kodstandard
i | Grupp 2 Lagerrobot

Utfärdat av hansn314
6 november 2014

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

## 5 Kodstruktur

Mellan slutet av en funktion, och början på nästa skall det vara två tomrader. Om kod struktureras internt i en funktion, separeras delar av en tomrad. Med fördel används även kommentarer för att förklara delmomenten i detta fall.
Indentering skall användas. En tab är 4 tecken lång. Notera att tab skall användas, inte mellanslag. Måsvingar skrivs på ny rad. Om en loop kan skrivas på en rad, kan den göras det. Då görs den så med mellanslag efter loopen och utan måsvingar.

i n t f o o ( )
{
w hil e ( 1 )
{
/∗ Code h e r e ∗/
}
w hil e ( 1 ) dosomething ( ) ; }

TSEA29
Kodstandard
ii | Grupp 2 Lagerrobot
