ultralaserdeluxe/gloria/dokumentation/anvandarhandledning/screenshot-gui.png

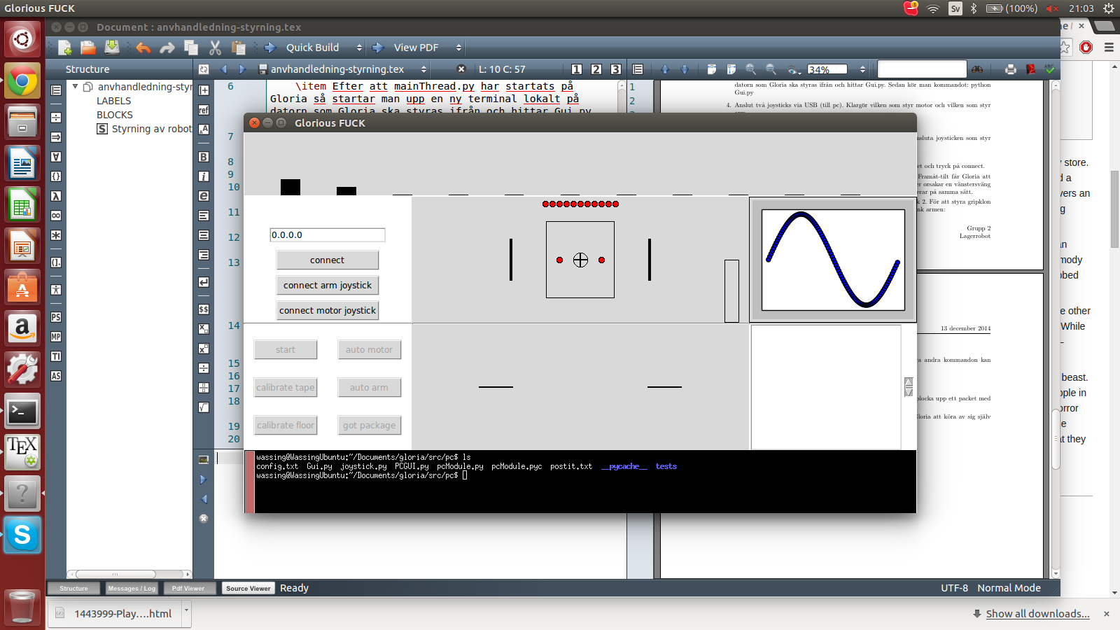
dokumentation/anvandarhandledning/screenshot-gui.png
