ultralaserdeluxe/gloria/dokumentation/mall/Logga2.png

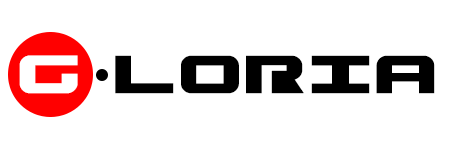
dokumentation/mall/Logga2.png
