ultralaserdeluxe/gloria/dokumentation/mall/Logga3.png

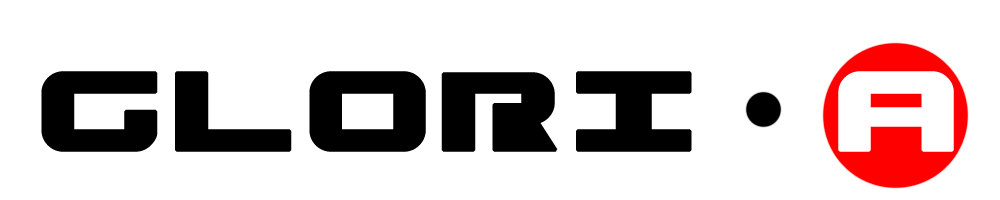
dokumentation/mall/Logga3.png
