ultralaserdeluxe/gloria/dokumentation/statusrapport/det_går_bra_nu.png

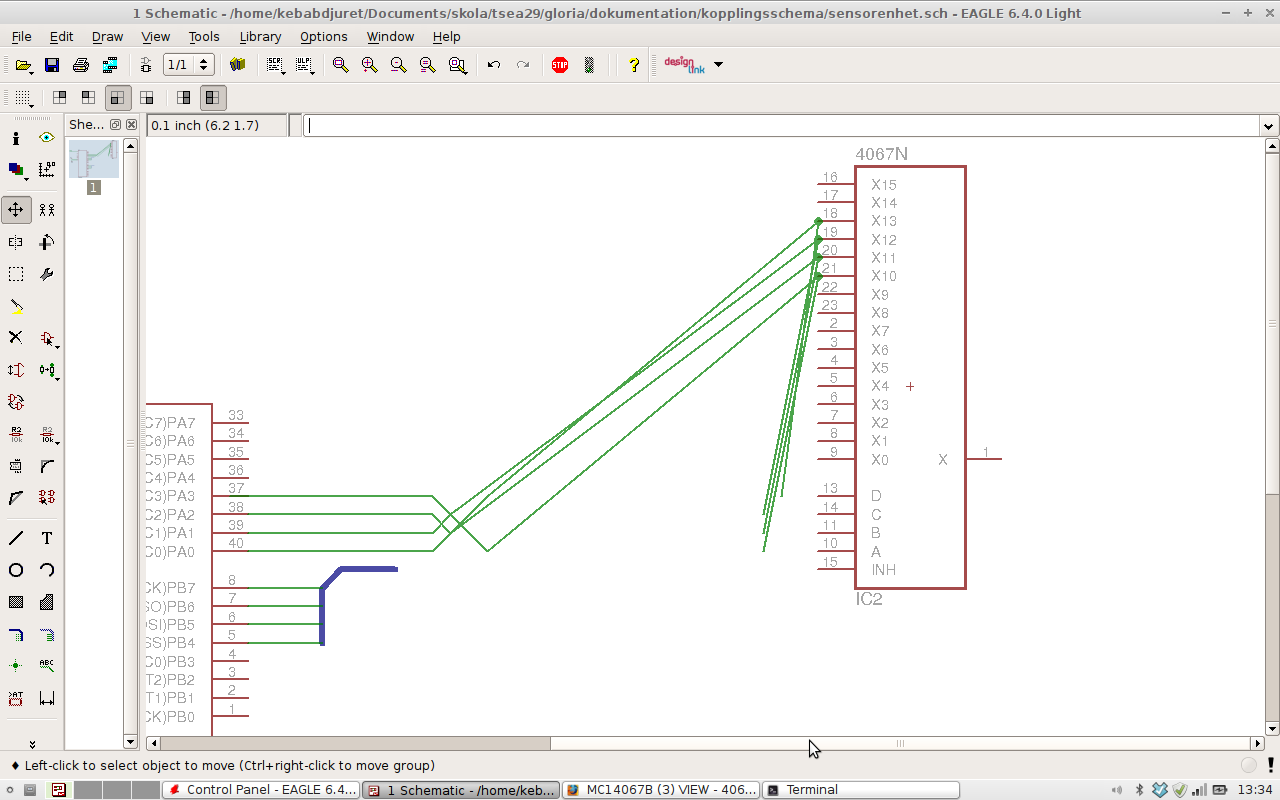
dokumentation/statusrapport/det_går_bra_nu.png
