ultralaserdeluxe/gloria/dokumentation/kopplingsschema/gloria/gloria_bom.xls

Amount | Part | Value | Device | Package | Description
2 | ATMEGA1284P, ATMEGA1284P1 |  | MEGA1284P | DIL40 | Atmel ATmega1284P 8-bit AVR Microcontroller
2 | LINEENABLEMUX1, LINEVALUEMUX1 |  | 4067N | DIL24-6 | 16-channel ANALOG MULTIPLEXER
1 | TRISTATE |  | 74LS125N | DIL14 | Quad bus BUFFER, 3-state
2 | U$1, U$2 |  | TXB0104 | SOIC(D) | TI TXB0104 4-Bit Bidirectional Voltage-Level Translator with Auto Direction Sensing
3 | C1, C3, C9 | 100n | C-EU025-024X044 | C025-024X044 | CAPACITOR, European symbol
4 | C2, C6, C11, C12 | 22p | C-EU025-024X044 | C025-024X044 | CAPACITOR, European symbol
1 | R1 | 10k | R-EU_0204/2V | 0204V | RESISTOR, European symbol
2 | Q1, Q2 | 16M | XTAL/S | QS | CRYSTAL
1 | JP1 |  | POWER_JACKSLT | POWER_JACK_SLOT | Power Jack
3 | JTAG_SEN, JTAG_STYR, MOTOR |  | 057-010-1 | 057-010-1 | CONNECTOR 10P
3 | SENSOR_DISTANCE_1, SENSOR_DISTANCE_2, SERVO_UART |  | 22-23-2031 | 22-23-2031 | .100" (2.54mm) Center Header - 3 Pin
1 | SENSOR_LINE |  | 057-026-1 | 057-026-1 | CONNECTOR 26P
1 | X |  | 057-020-1 | 057-020-1 | CONNECTOR 20P
