ultralaserdeluxe/gloria/cad/Reactor_SOLID/Reactor_SOLID_Nowrist.stp

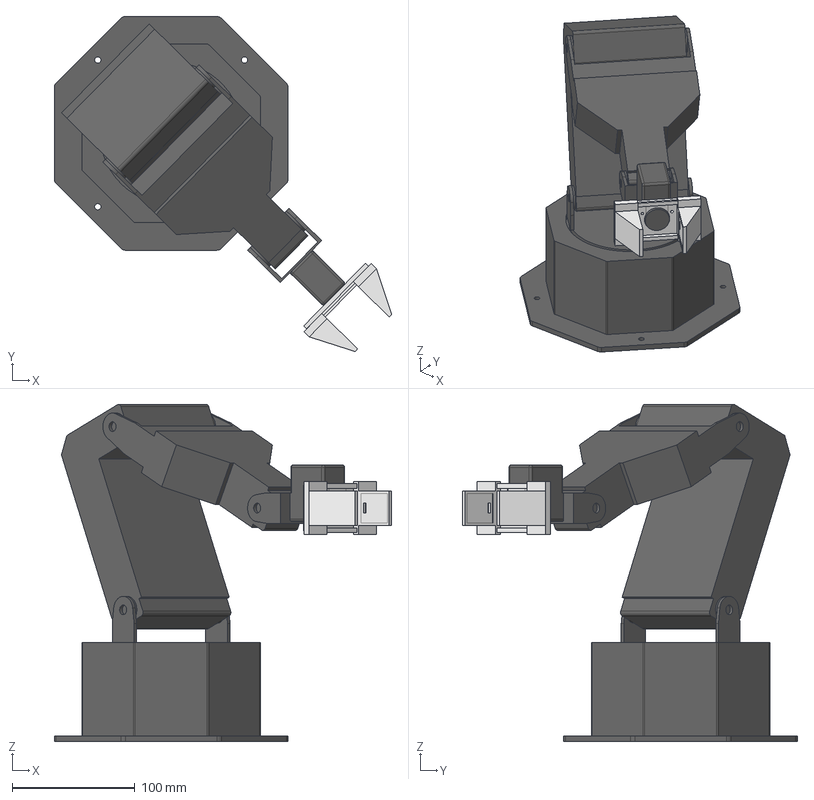
[picture p74: CAD file, 2014-11-03]
cad/Reactor_SOLID/Reactor_SOLID_Nowrist.stp
275.3 x 273.3 x 275.1 mm
Base
Shoulder
Bicep
ForeArm
Wrist
Guide_Rail_Fixed
Gripper_Hand_Fixed x 2
