ultralaserdeluxe/gloria/cad/Reactor_SOLID/axel1.fcstd

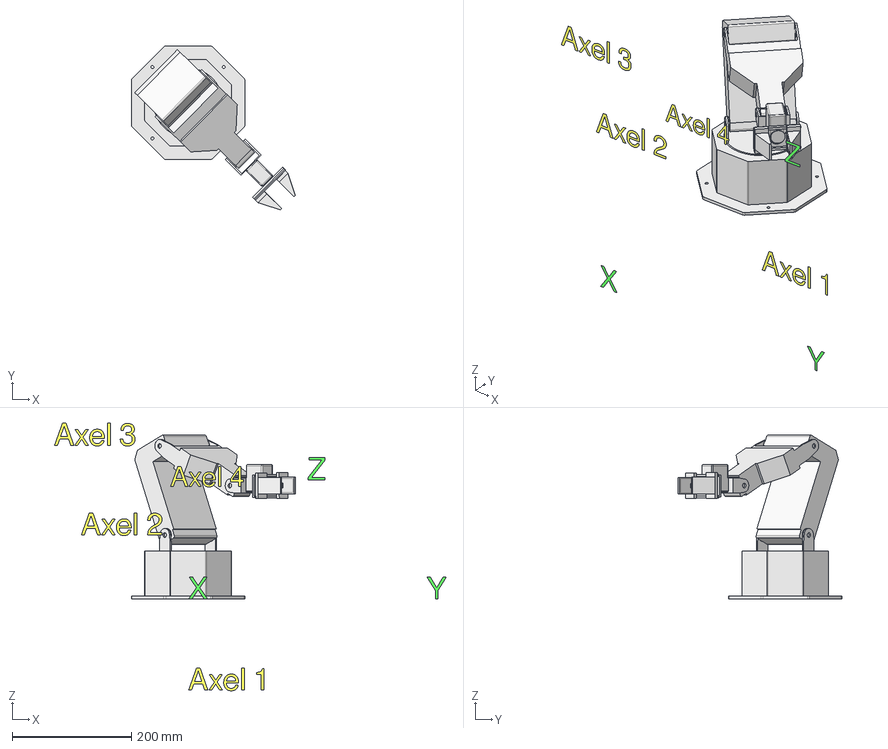
[picture p75: CAD file, 2014-11-03]
cad/Reactor_SOLID/axel1.fcstd
658.0 x 495.4 x 449.4 mm
Reactor_SOLID
Reactor_SOLID001
Reactor_SOLID002
Reactor_SOLID003
Reactor_SOLID004
PX-Gripper
PX-Gripper001
PX-Gripper002
ShapeString
ShapeString001
ShapeString002
ShapeString003
ShapeString004
ShapeString005
ShapeString006
