ultralaserdeluxe/gloria/(list of files, cad)

Other CAD files:
cad/Reactor_SOLID/gdgd.fcstd
cad/Reactor_SOLID/Base.ipt
cad/Reactor_SOLID/Bicep.ipt
cad/Reactor_SOLID/ForeArm.ipt
cad/Reactor_SOLID/Imported Components/PX-Gripper/Gripper_Hand_Fixed.ipt
cad/Reactor_SOLID/Imported Components/PX-Gripper/Guide_Rail_Fixed.ipt
cad/Reactor_SOLID/Imported Components/PX-Gripper/PX-Gripper.iam
cad/Reactor_SOLID/Reactor_SOLID.iam
cad/Reactor_SOLID/Reactor_SOLID_Nowrist.iam
cad/Reactor_SOLID/Shoulder.ipt
cad/Reactor_SOLID/Wrist.ipt
cad/Reactor_SOLID/Wrist2.ipt
