ultralaserdeluxe/gloria/dokumentation/designspecifikation/grafik/trash/Styrlogik.pdf

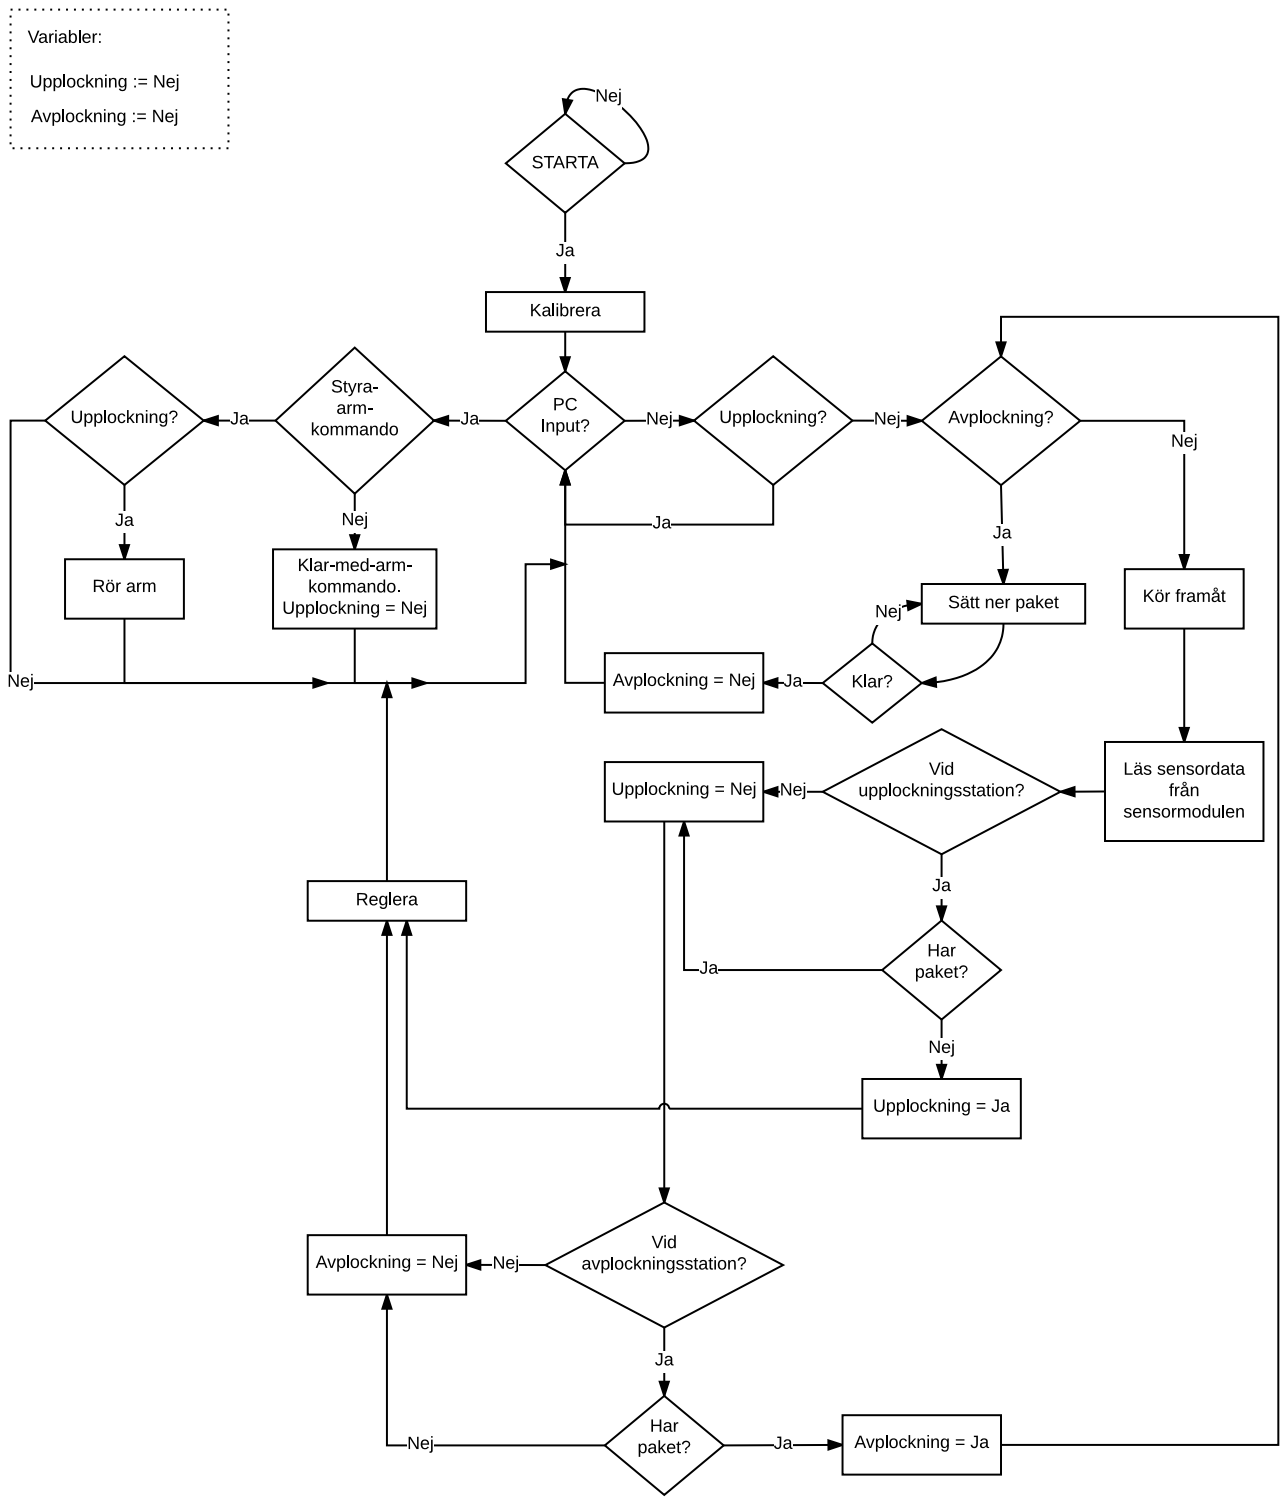
[picture p76: page 1]
