ultralaserdeluxe/gloria/dokumentation/tekniskdokumentation/grafik/sensorenhet-processor-eps-converted-to.pdf

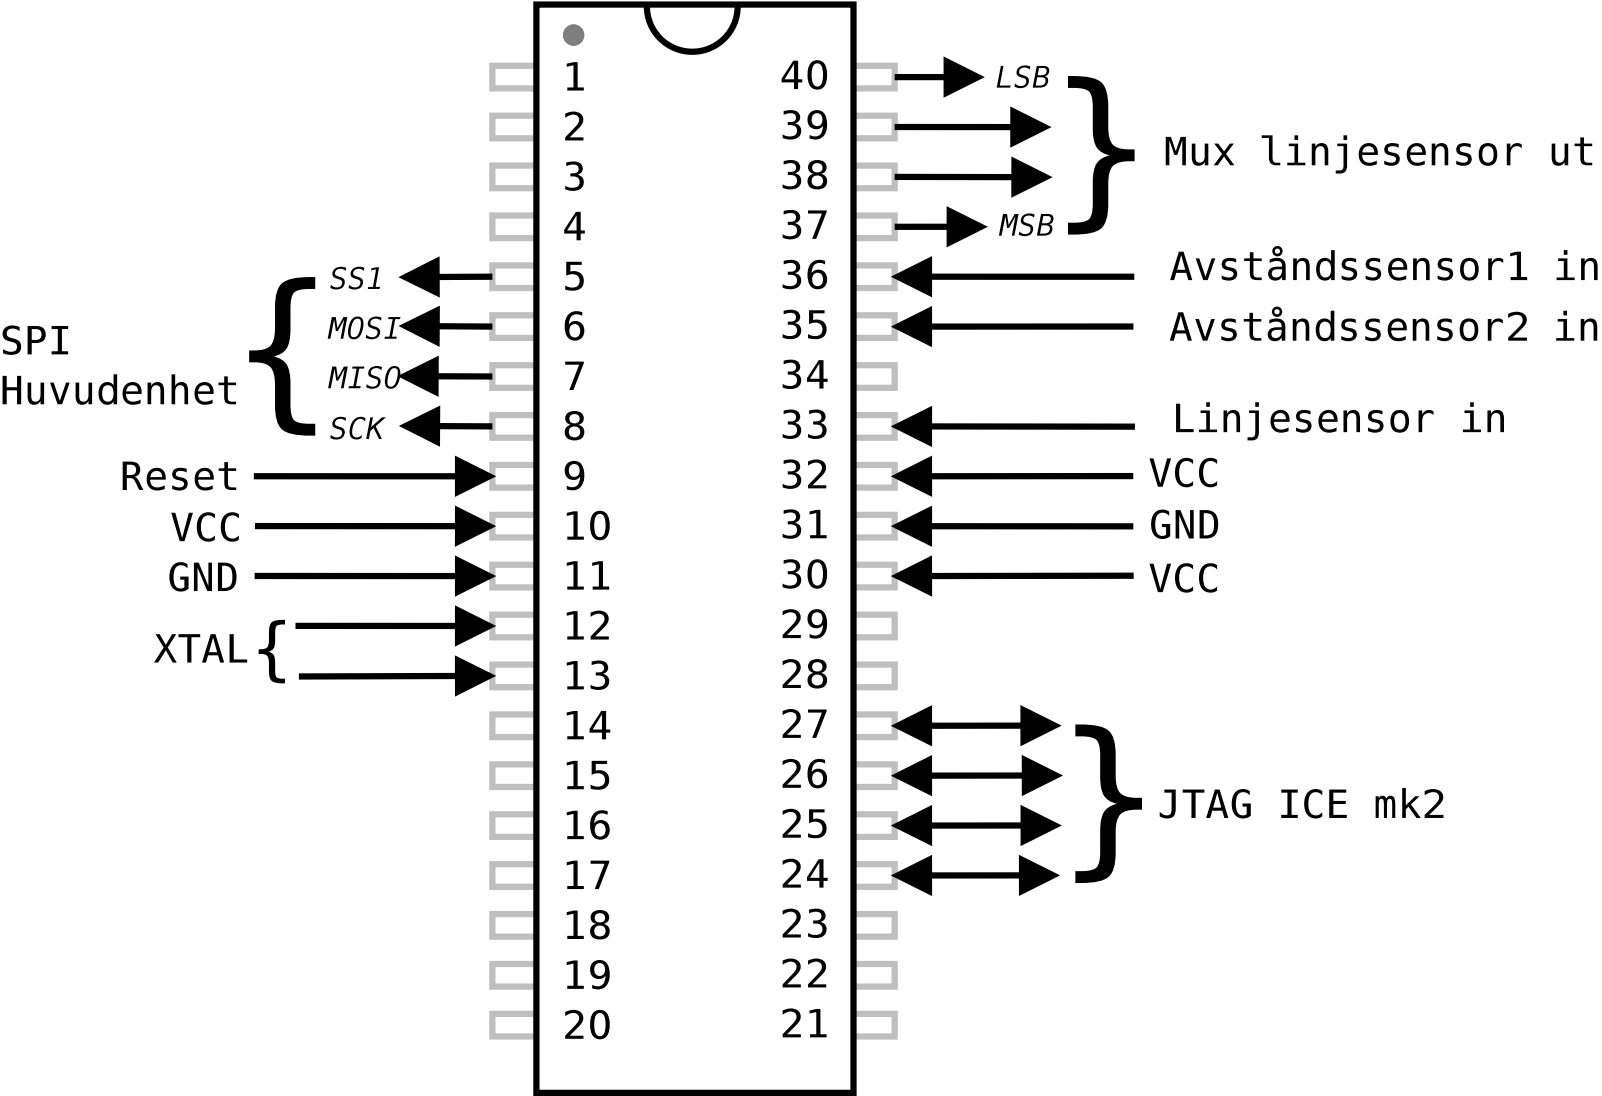
[picture p77: page 1]
