ultralaserdeluxe/gloria/dokumentation/tekniskdokumentation/grafik/styrenhet-processor-eps-converted-to.pdf

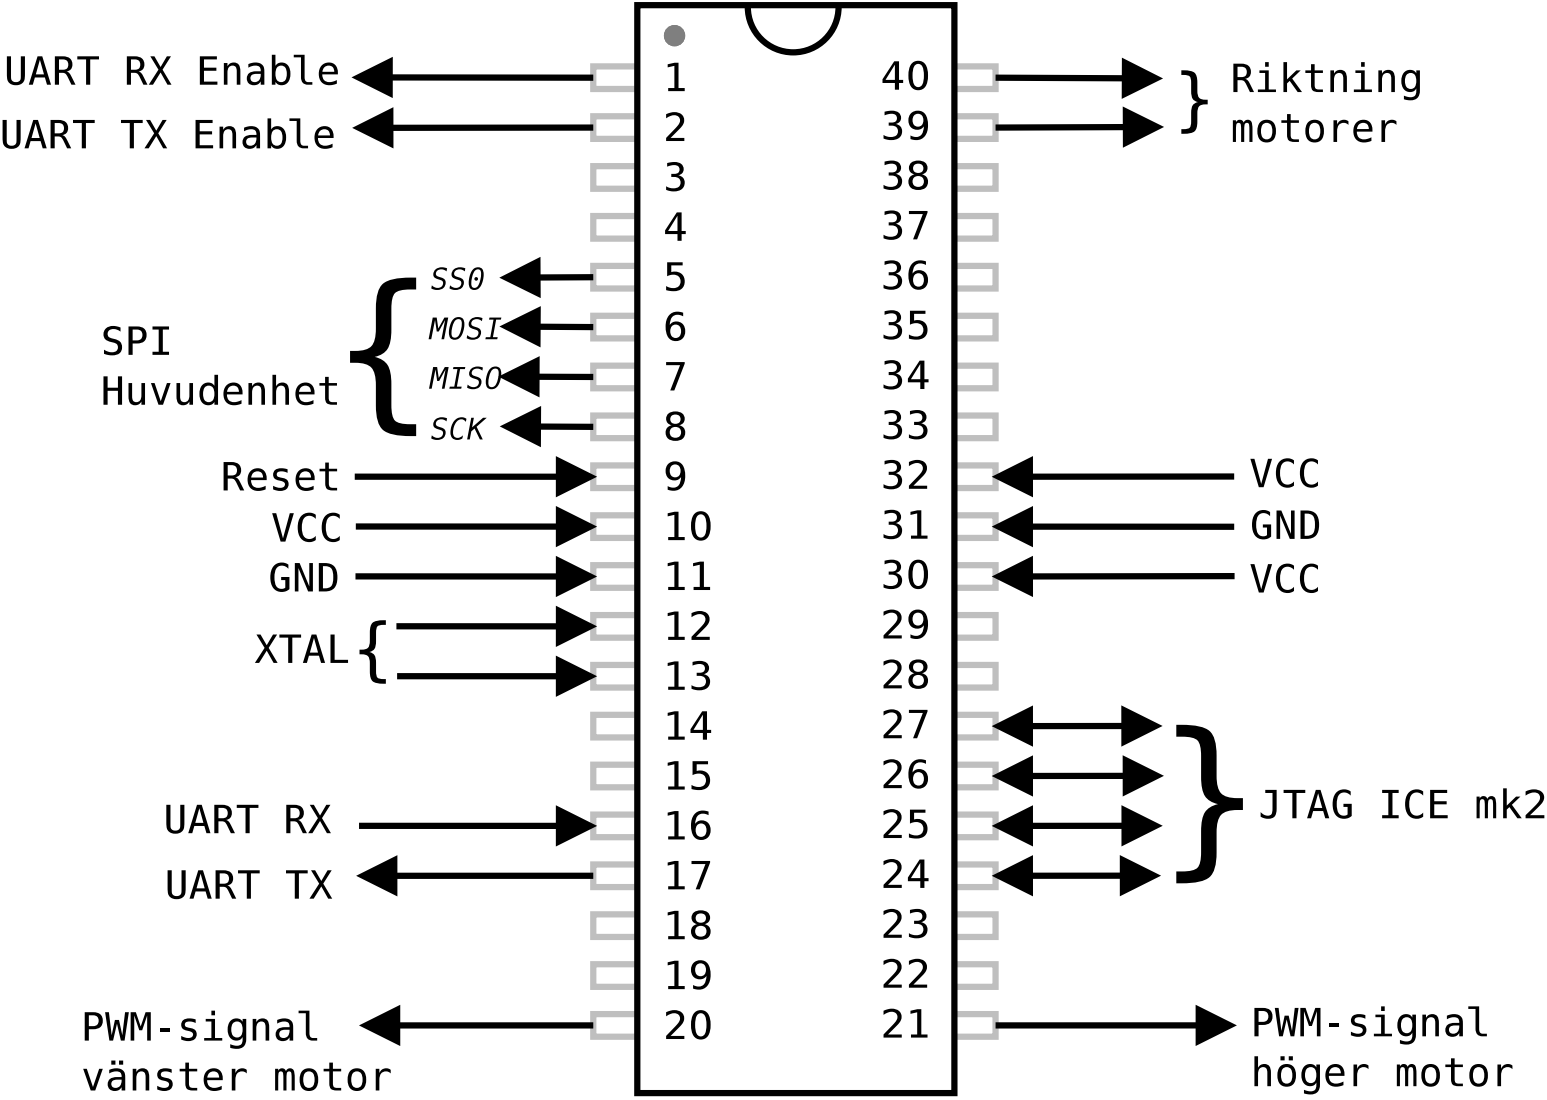
[picture p78: page 1]
