ultralaserdeluxe/gloria/dokumentation/tekniskdokumentation/grafik/kommunikation-oversikt-eps-converted-to.pdf

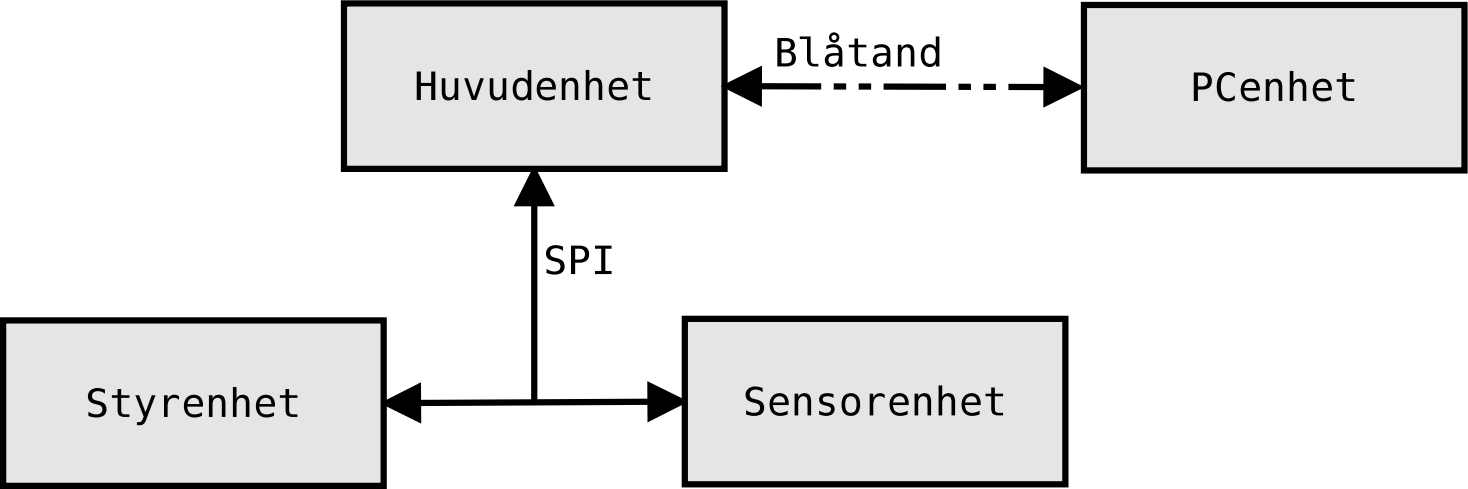
[picture p79: page 1]
