ultralaserdeluxe/gloria/dokumentation/tekniskdokumentation/grafik/sensorenhet-oversikt-eps-converted-to.pdf

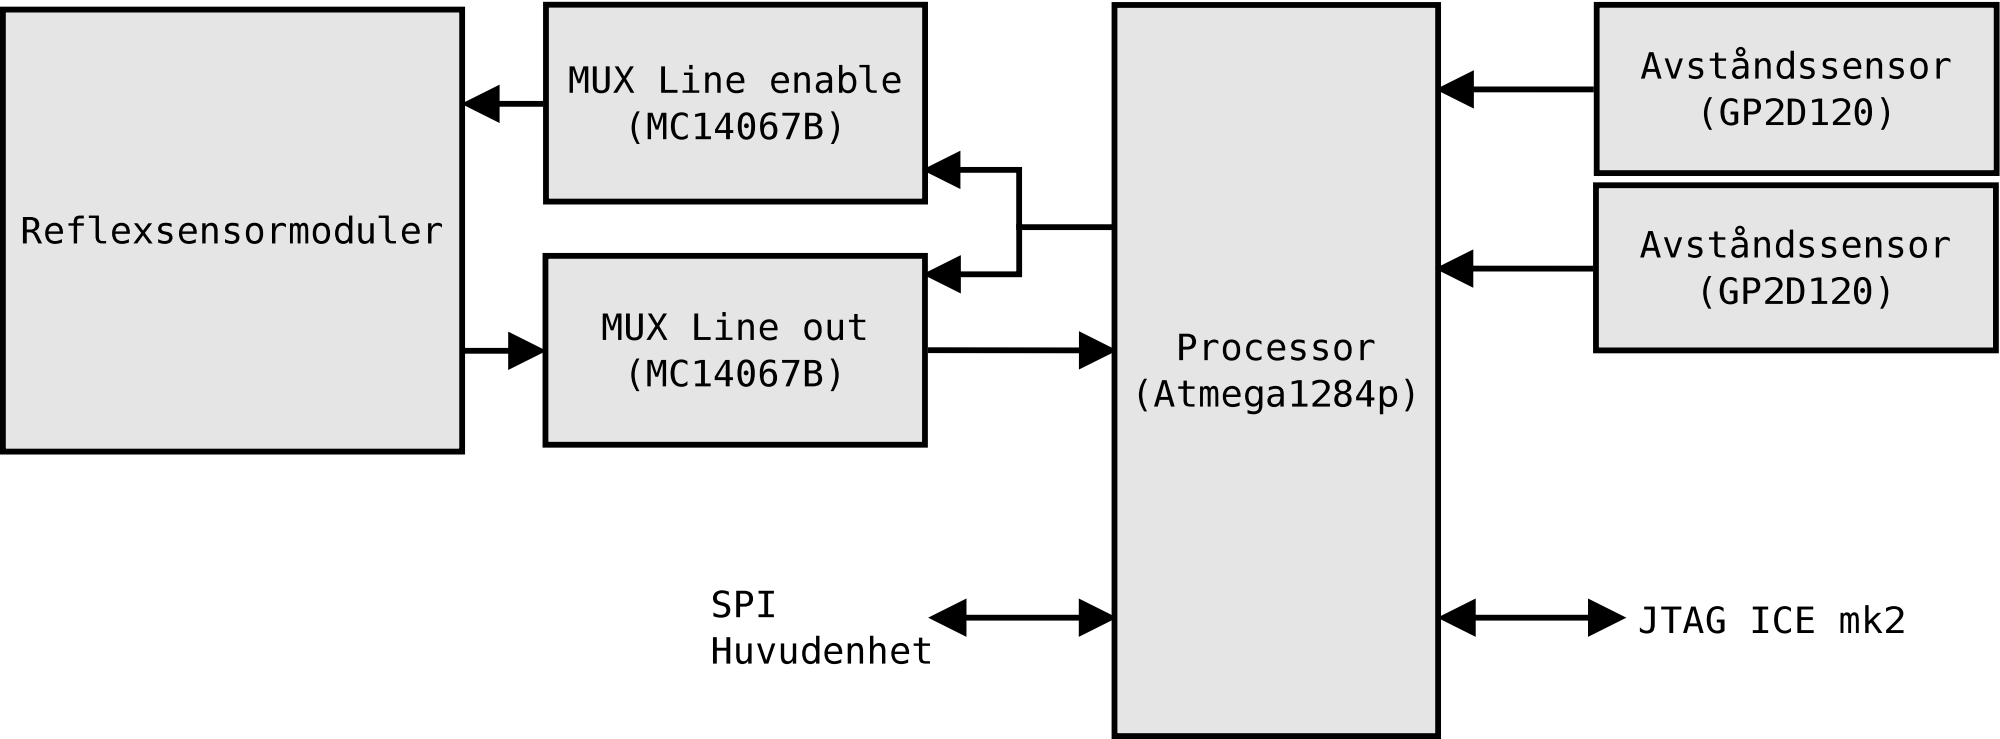
[picture p80: page 1]
