ultralaserdeluxe/gloria/dokumentation/tekniskdokumentation/grafik/system-oversikt-eps-converted-to.pdf

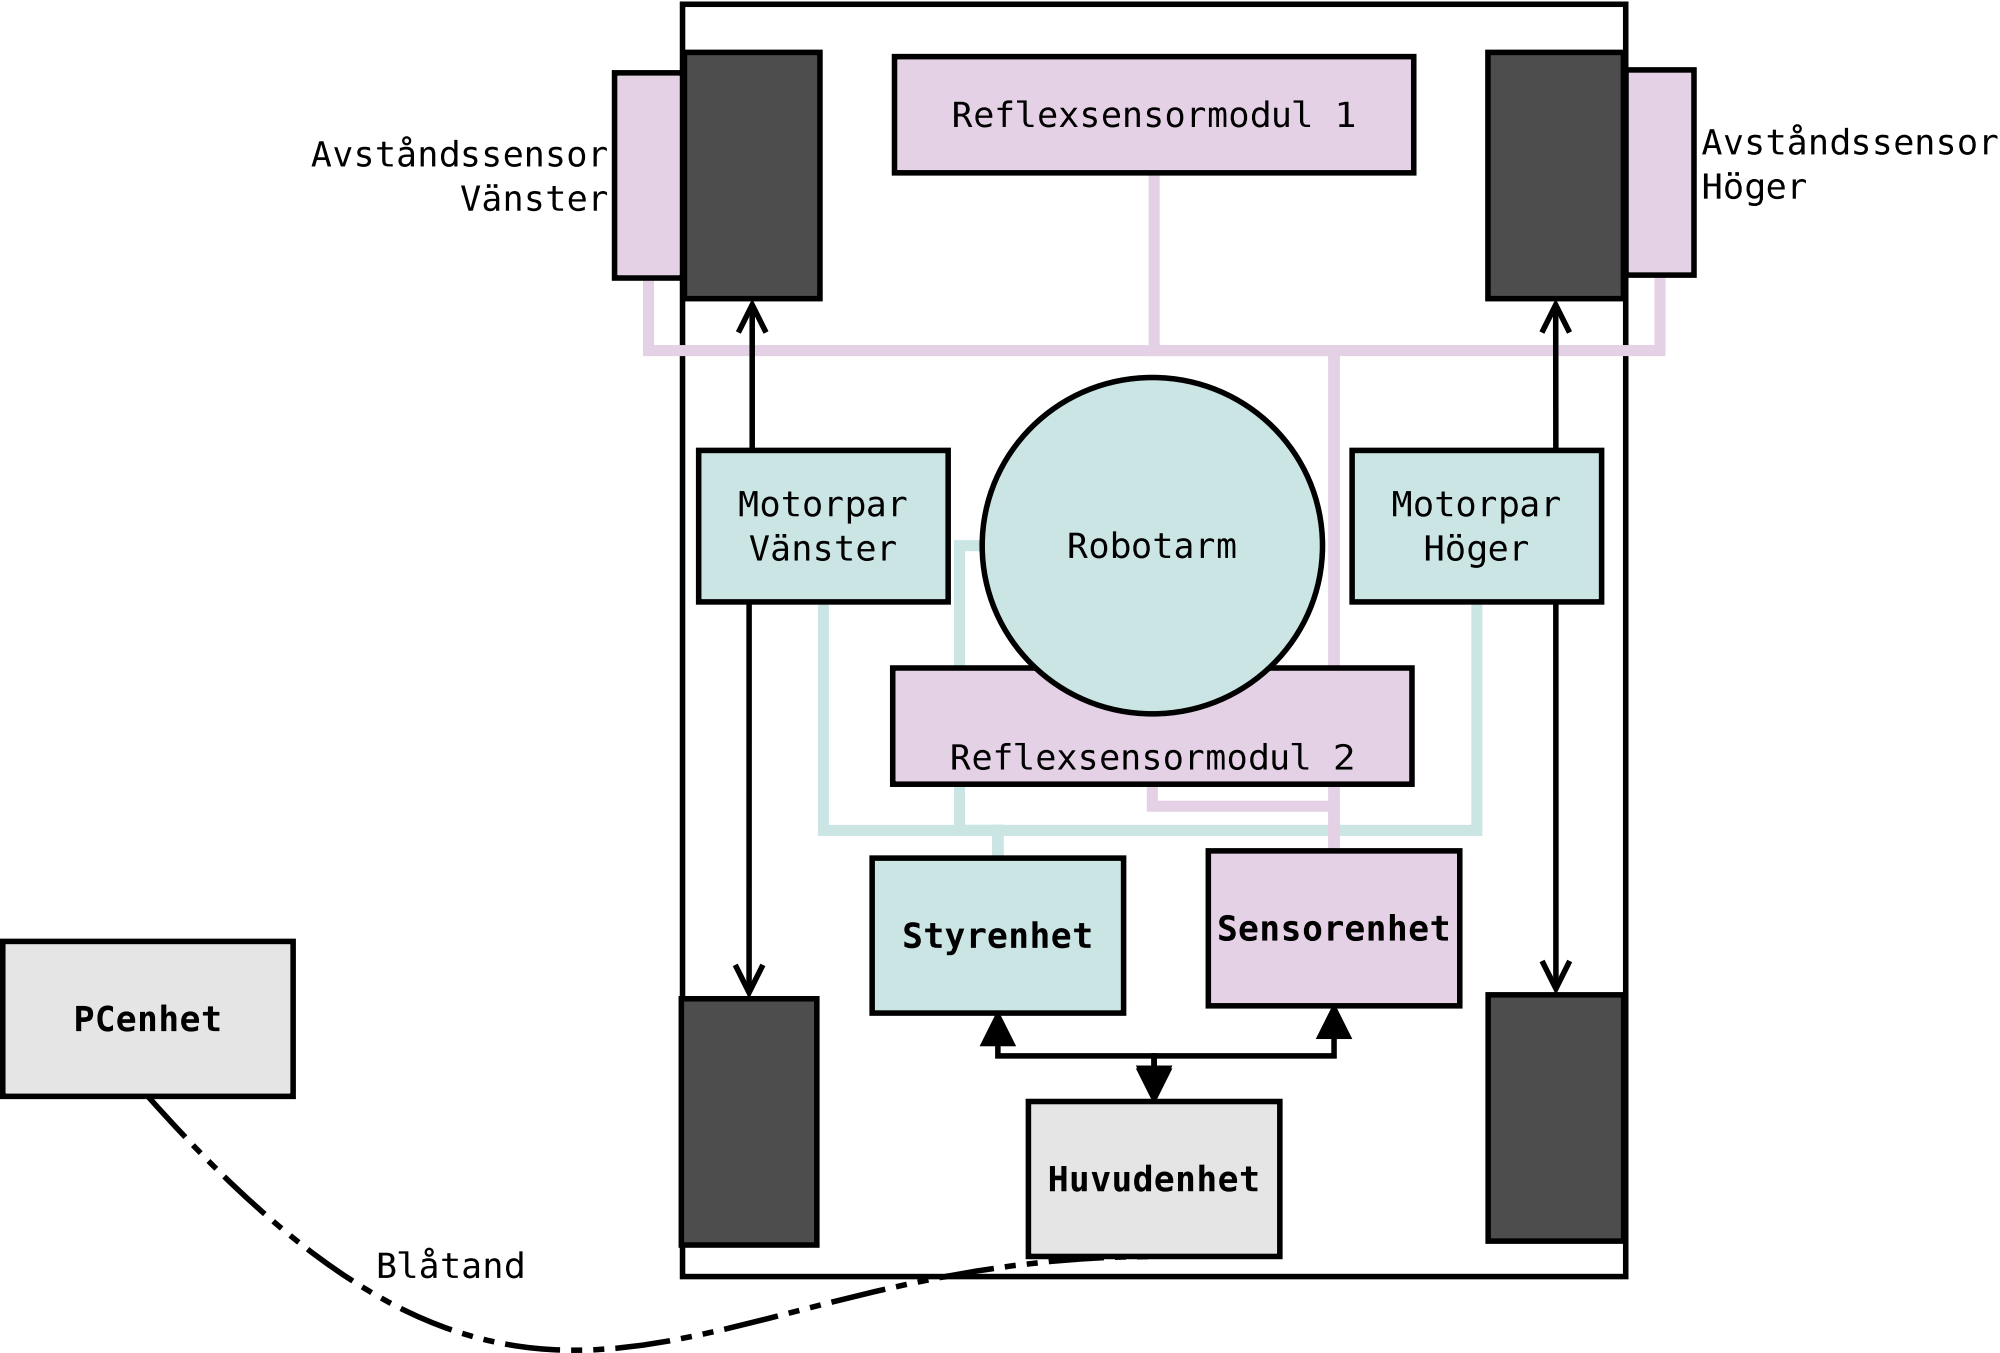
[picture p81: page 1]
