ultralaserdeluxe/gloria/dokumentation/tekniskdokumentation/grafik/huvud-tillstand-eps-converted-to.pdf

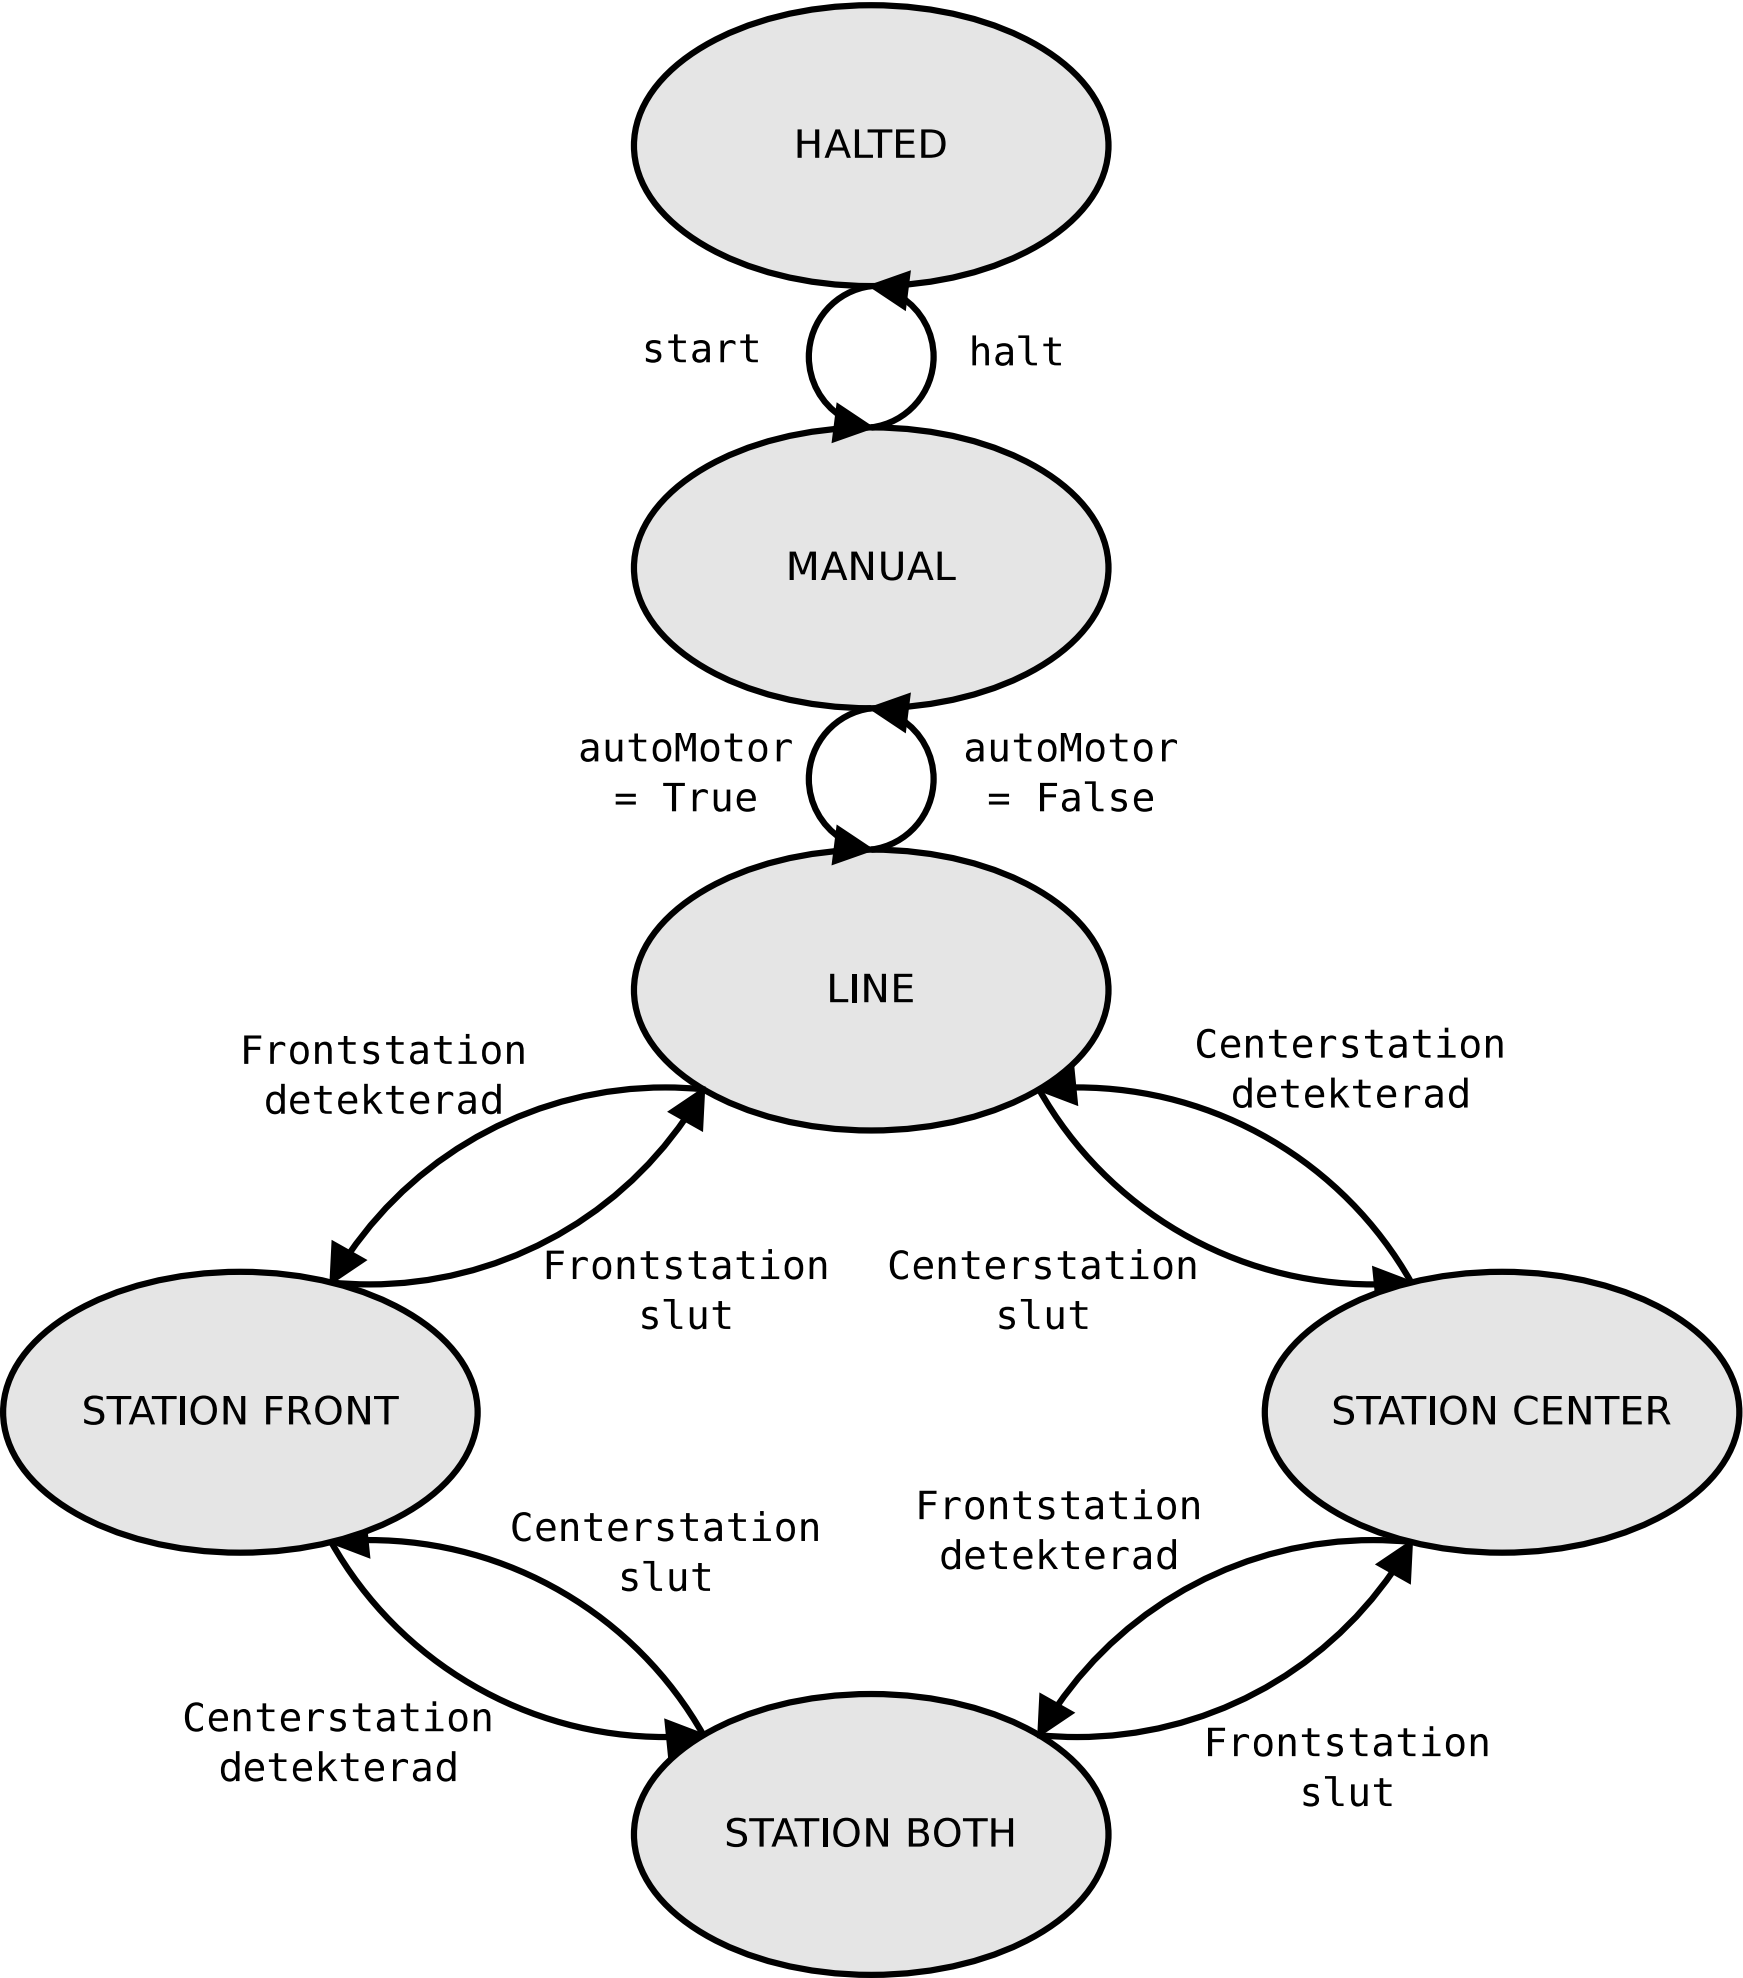
[picture p82: page 1]
