ultralaserdeluxe/gloria/dokumentation/tekniskdokumentation/grafik/huvud-tradar-eps-converted-to.pdf

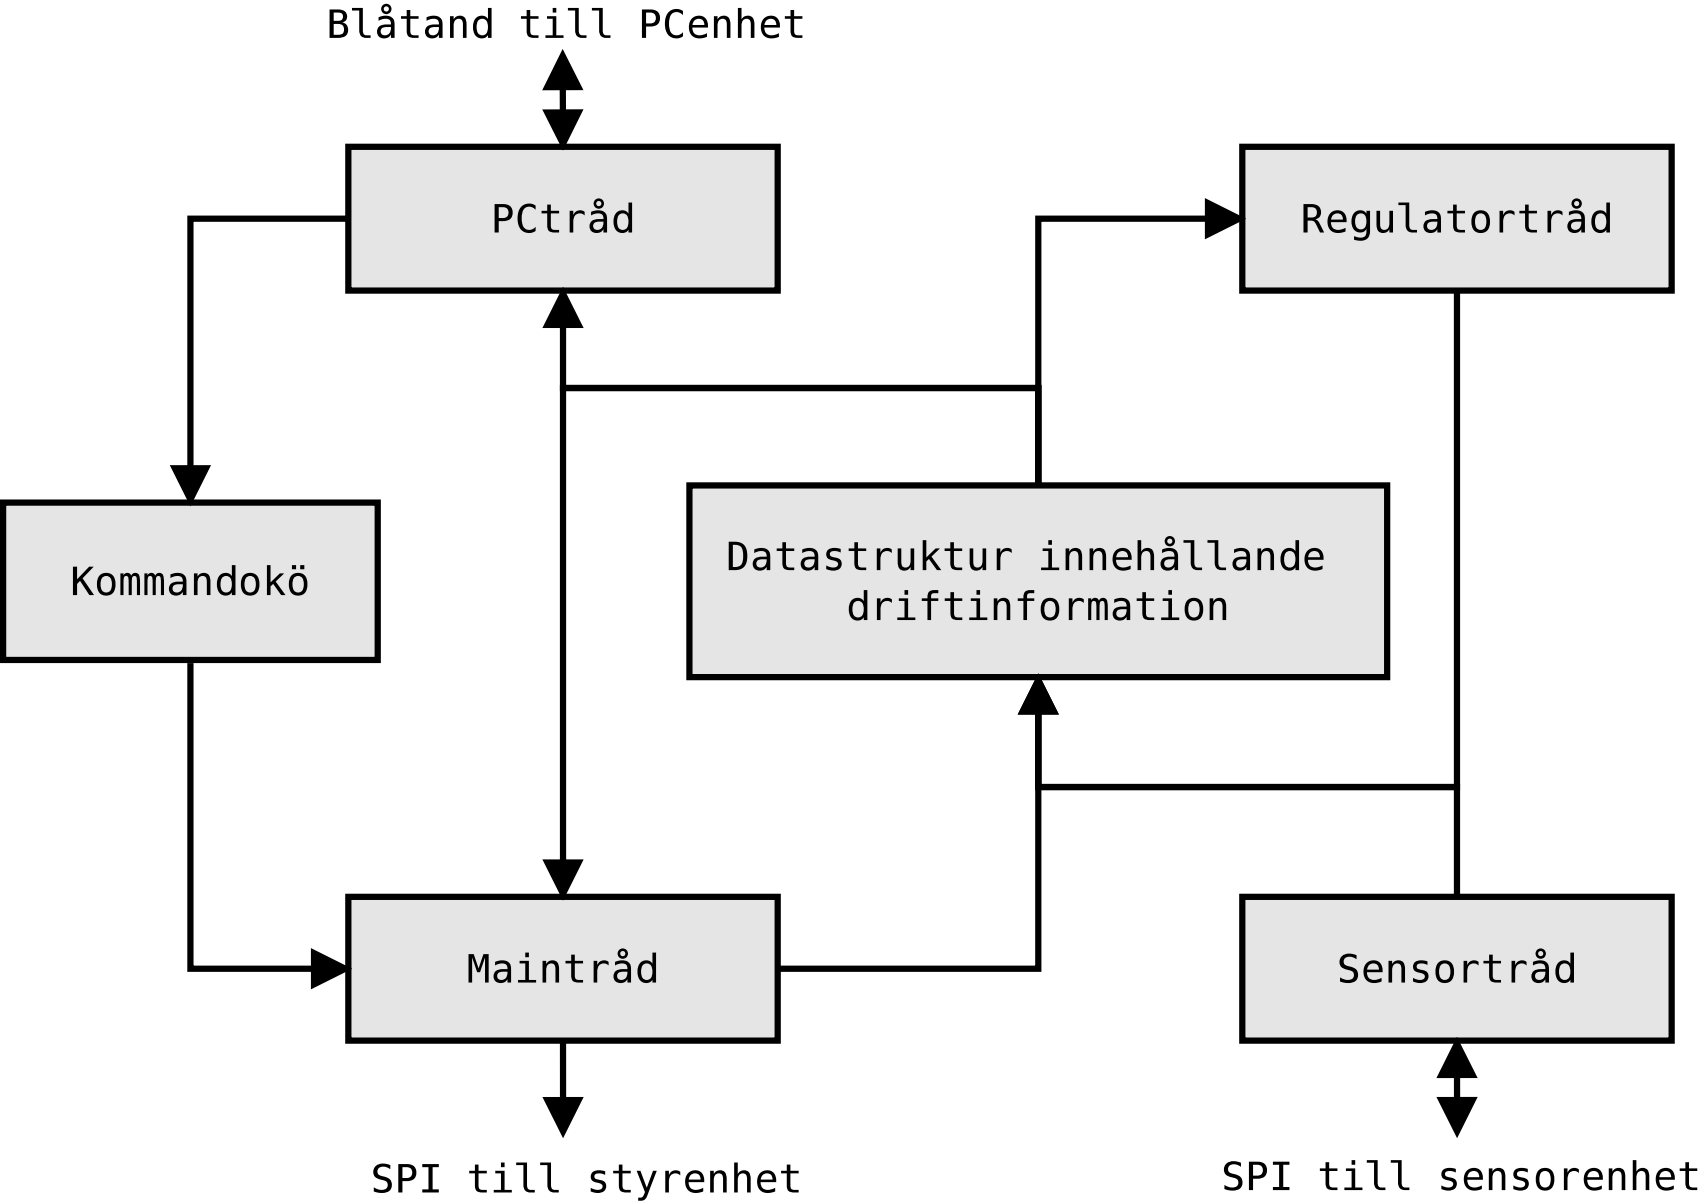
[picture p83: page 1]
