ultralaserdeluxe/gloria/dokumentation/tekniskdokumentation/grafik/kopplingsschema-pcb.pdf

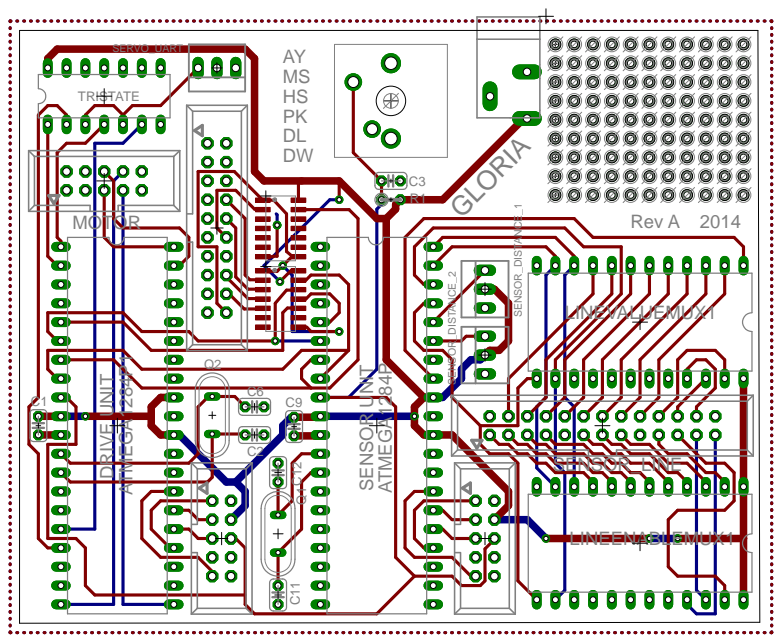
[picture p84: page 1]
