ultralaserdeluxe/gloria/dokumentation/tekniskdokumentation/grafik/sensorenhet-mjukvara-eps-converted-to.pdf

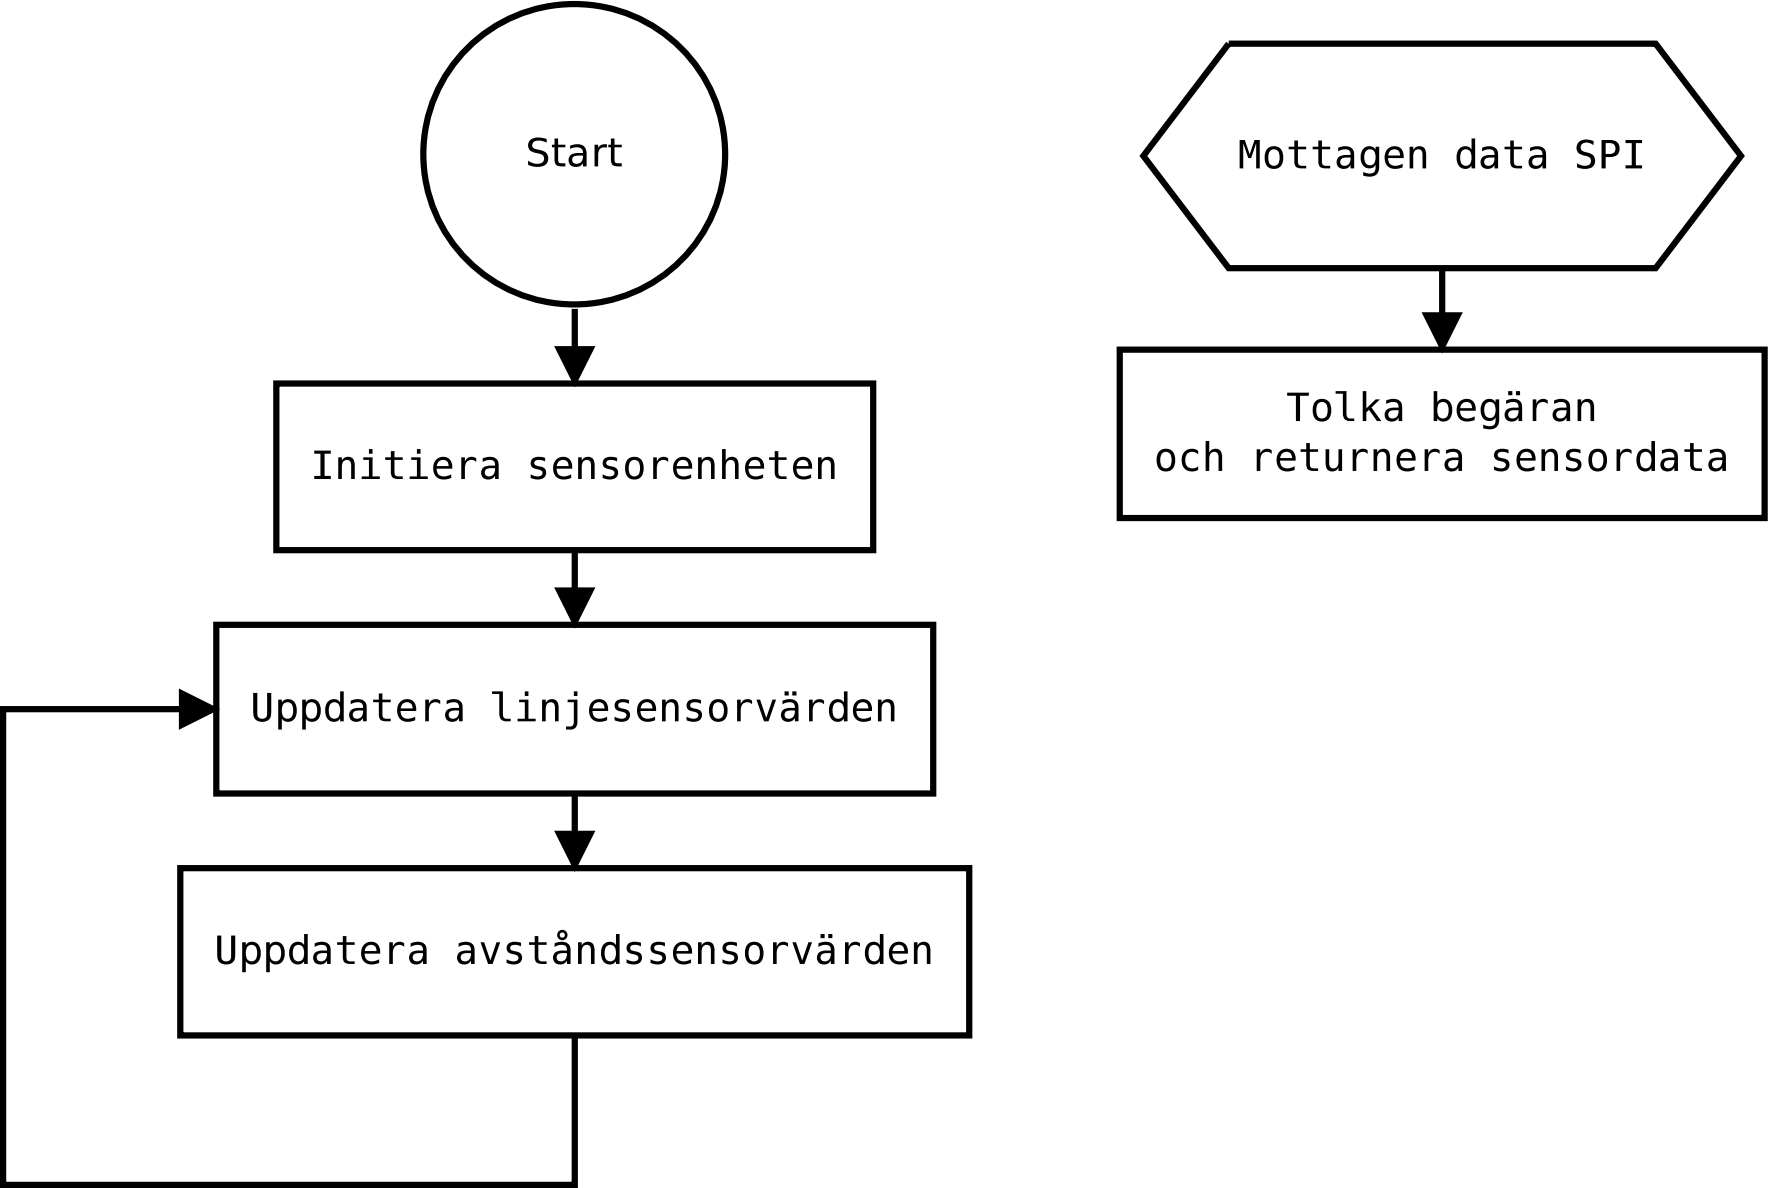
[picture p85: page 1]
