ultralaserdeluxe/gloria/dokumentation/tekniskdokumentation/grafik/styr-mjukvara-eps-converted-to.pdf

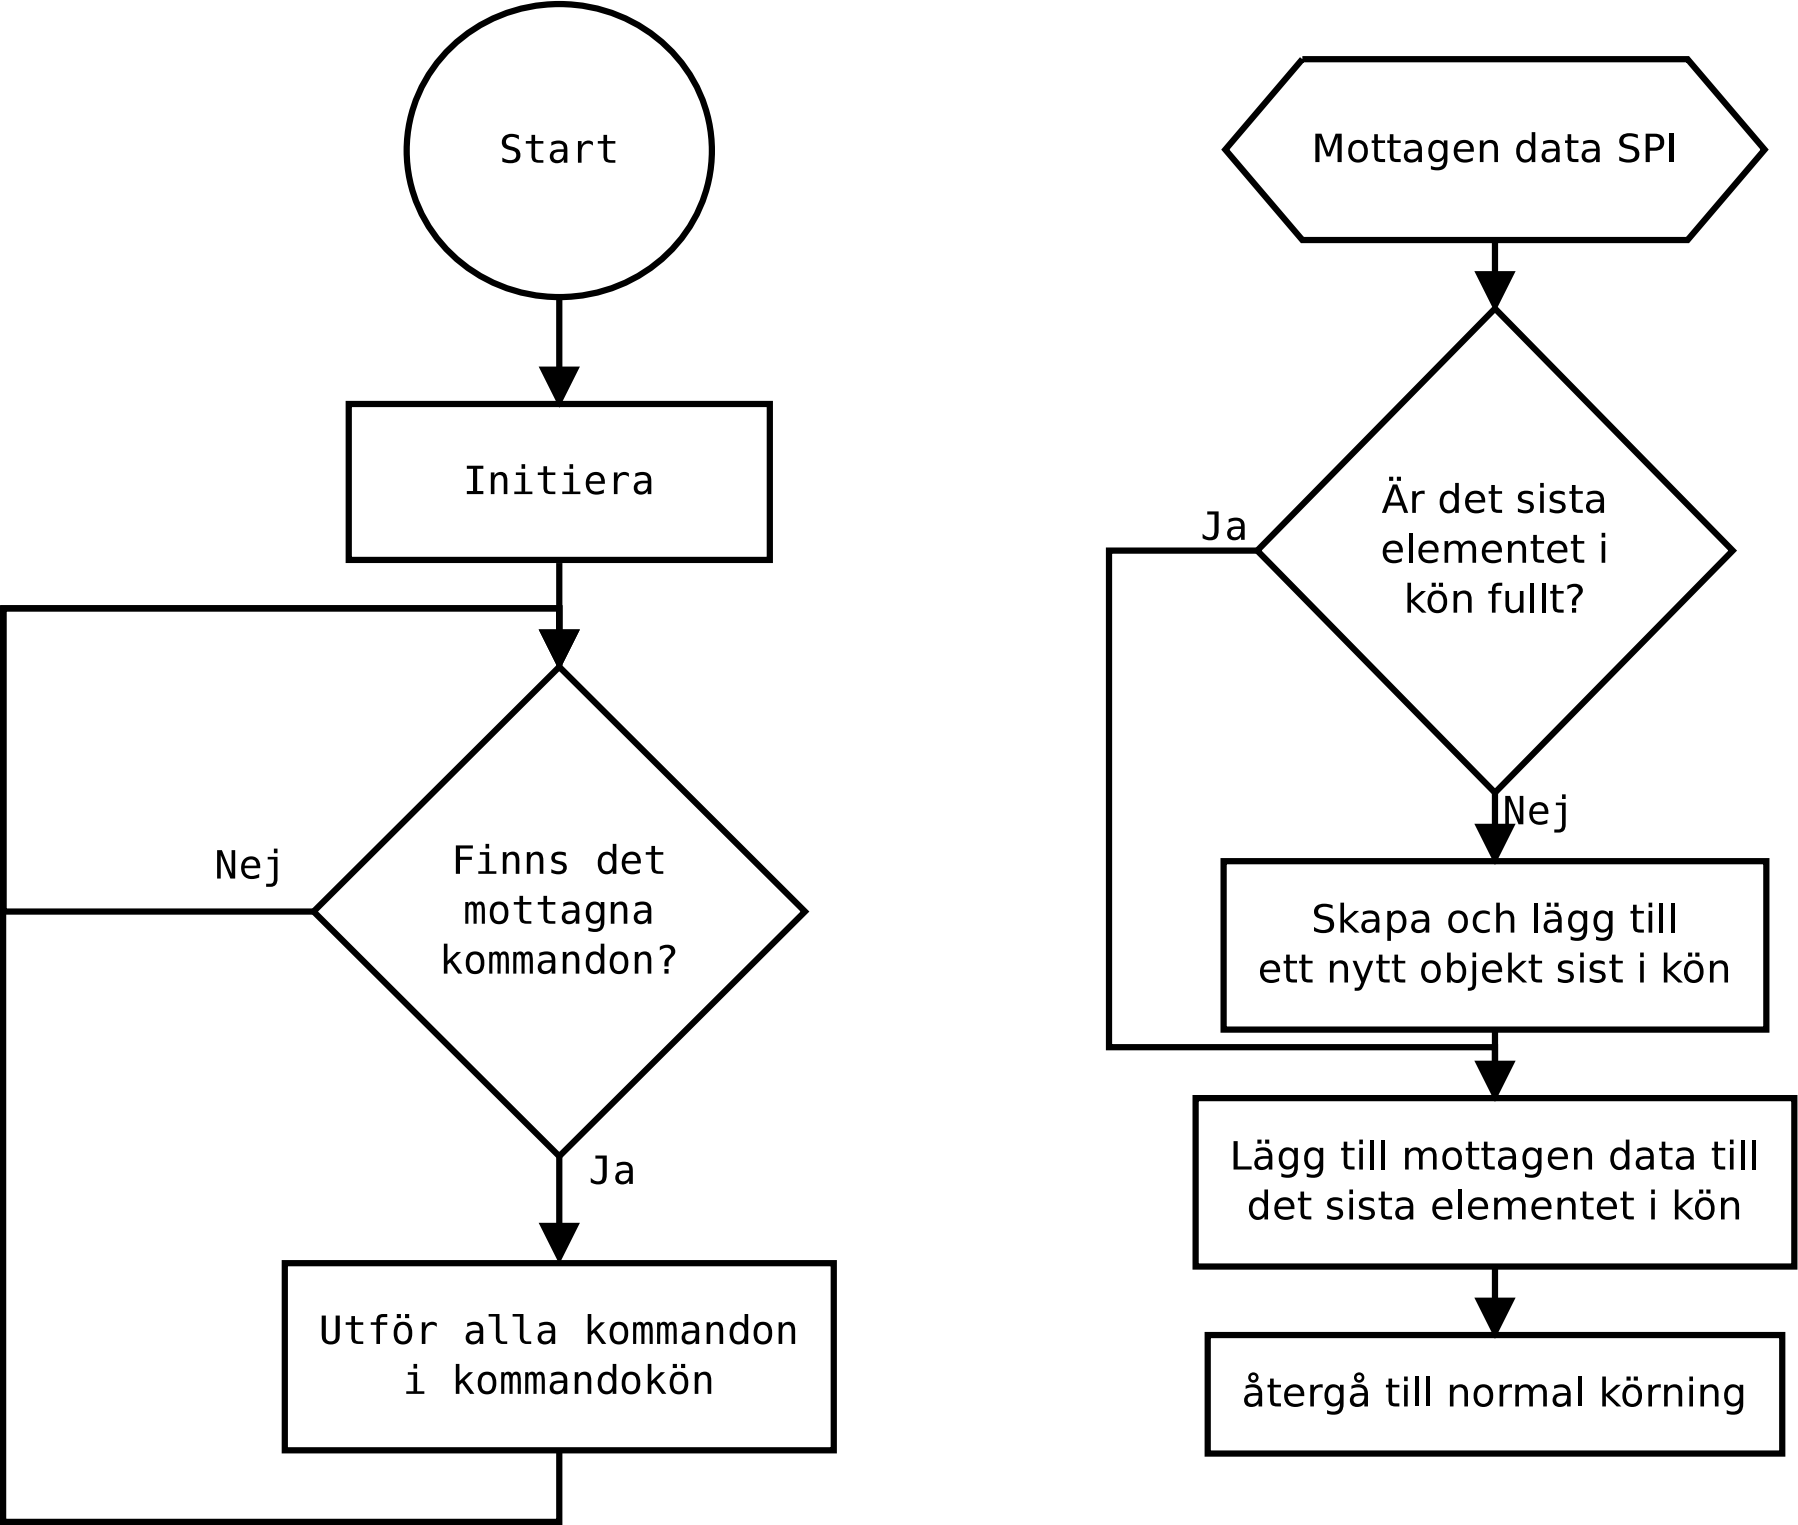
[picture p86: page 1]
