ultralaserdeluxe/gloria/dokumentation/tekniskdokumentation/grafik/styrenhet-oversikt-eps-converted-to.pdf

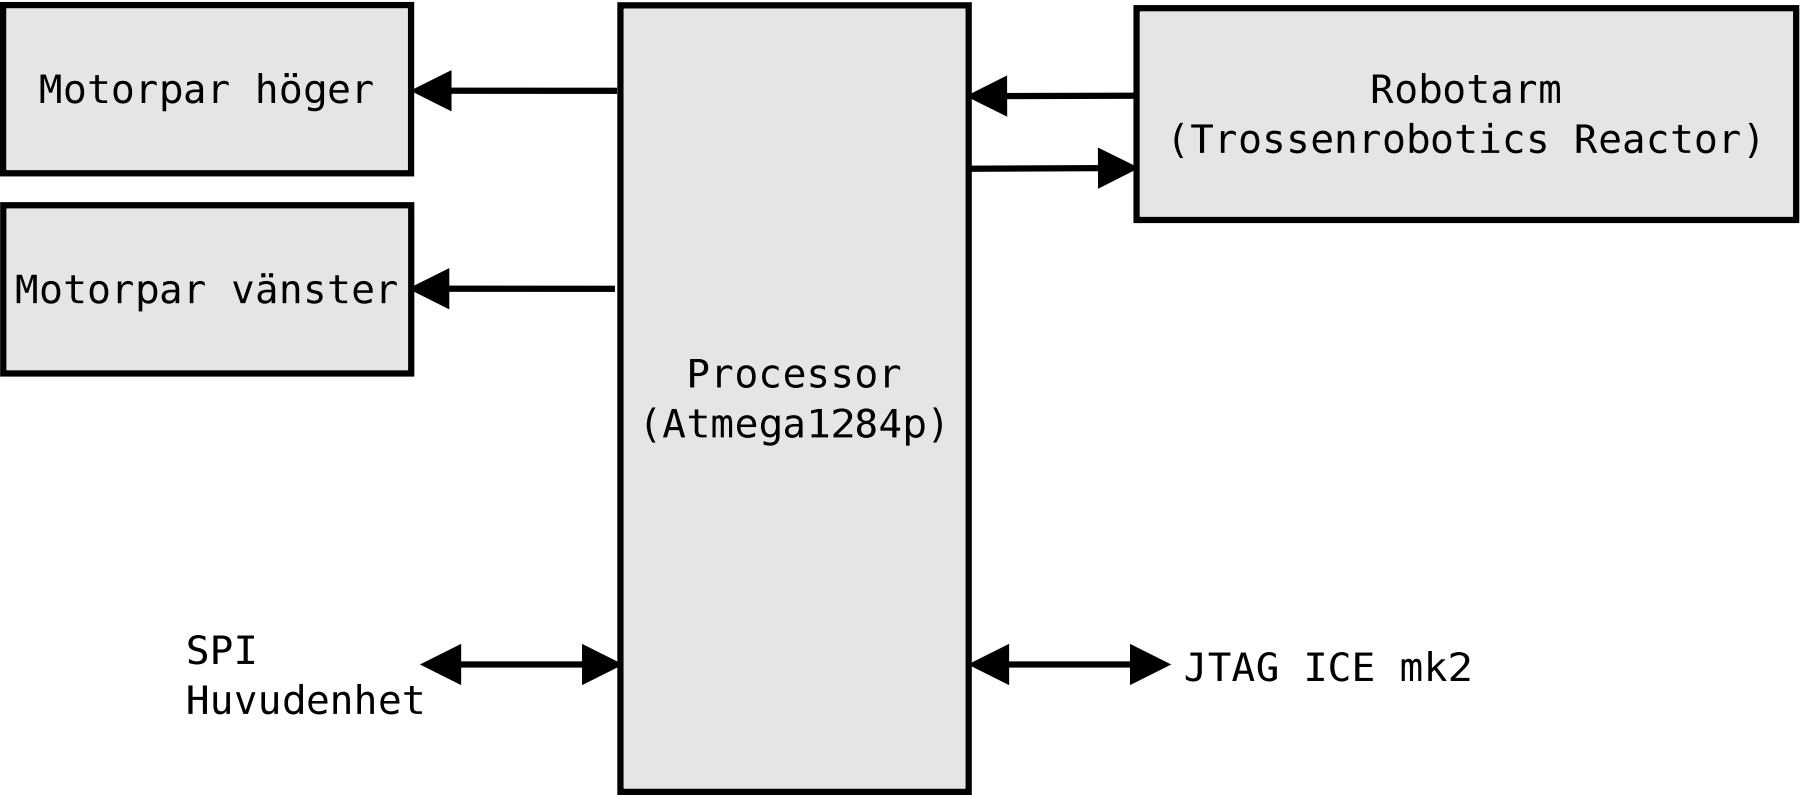
[picture p87: page 1]
