ultralaserdeluxe/gloria/dokumentation/kopplingsschema/gloria/gloria.brd

## EAGLE design dokumentation/kopplingsschema/gloria/gloria.brd (2014-11-29)

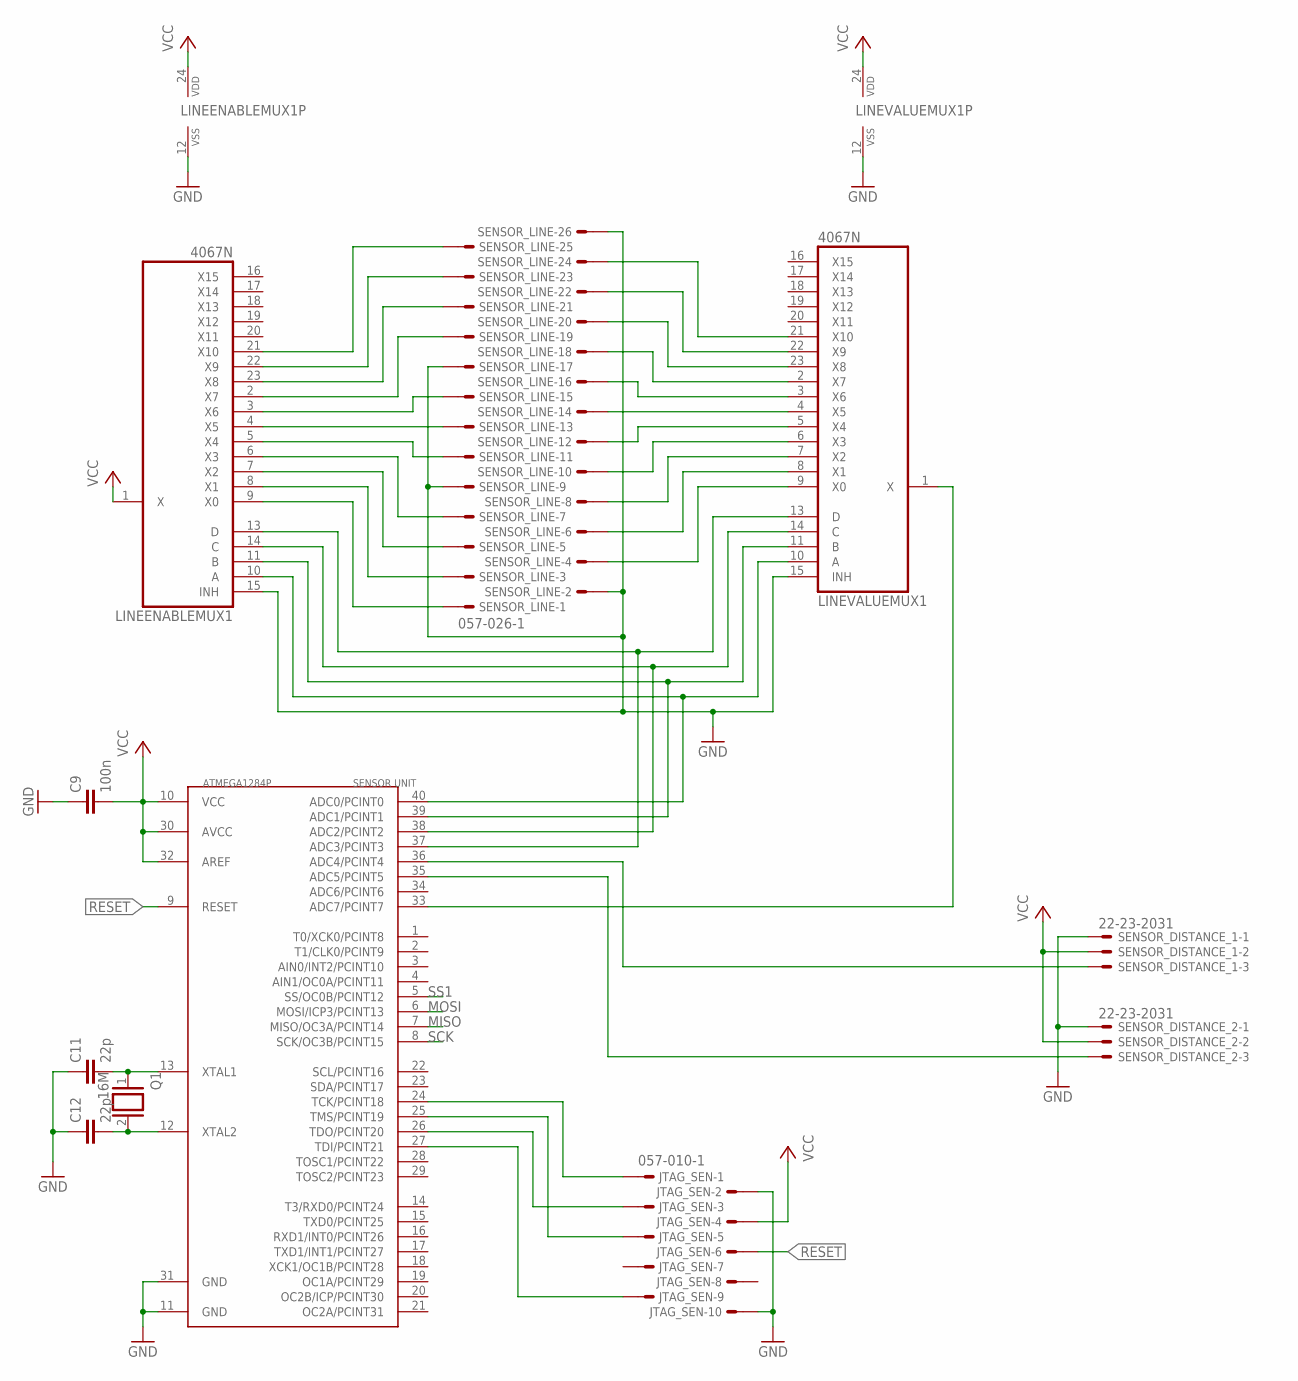
[picture p88: schematic gloria.sch, sheet 1, Sensorenhet]

Parts:
ATMEGA1284P: SENSOR UNIT; DIL40
C9: 100n; C025-024X044
C11, C12: 22p; C025-024X044
JTAG_SEN: 057-010-1
LINEENABLEMUX1: 4067N; DIL24-6
LINEVALUEMUX1: 4067N; DIL24-6
Q1: 16M; QS
SENSOR_DISTANCE_1, SENSOR_DISTANCE_2: 22-23-2031
SENSOR_LINE: 057-026-1

Connections:
DISTANCELEFT: ATMEGA1284P.36 (ADC4/PCINT4), SENSOR_DISTANCE_1.3
GND: ATMEGA1284P.11 (GND), ATMEGA1284P.31 (GND), C9.1, C11.1, C12.1, JTAG_SEN.2, JTAG_SEN.10, LINEENABLEMUX1.12 (VSS), LINEENABLEMUX1.15 (INH), LINEVALUEMUX1.12 (VSS), LINEVALUEMUX1.15 (INH), SENSOR_DISTANCE_1.1, SENSOR_DISTANCE_2.1, SENSOR_LINE.2, SENSOR_LINE.9, SENSOR_LINE.17, SENSOR_LINE.26; also elsewhere on the board
LINEADDR0: ATMEGA1284P.40 (ADC0/PCINT0), LINEENABLEMUX1.10 (A), LINEVALUEMUX1.10 (A)
LINEADDR1: ATMEGA1284P.39 (ADC1/PCINT1), LINEENABLEMUX1.11 (B), LINEVALUEMUX1.11 (B)
LINEADDR2: ATMEGA1284P.38 (ADC2/PCINT2), LINEENABLEMUX1.14 (C), LINEVALUEMUX1.14 (C)
LINEADDR3: ATMEGA1284P.37 (ADC3/PCINT3), LINEENABLEMUX1.13 (D), LINEVALUEMUX1.13 (D)
LINEVALUE: ATMEGA1284P.33 (ADC7/PCINT7), LINEVALUEMUX1.1 (X)
MISO: ATMEGA1284P.7 (MISO/OC3A/PCINT14); also elsewhere on the board
MOSI: ATMEGA1284P.6 (MOSI/ICP3/PCINT13); also elsewhere on the board
unnamed: ATMEGA1284P.27 (TDI/PCINT21), JTAG_SEN.9
unnamed: ATMEGA1284P.26 (TDO/PCINT20), JTAG_SEN.3
unnamed: ATMEGA1284P.25 (TMS/PCINT19), JTAG_SEN.5
unnamed: ATMEGA1284P.24 (TCK/PCINT18), JTAG_SEN.1
unnamed: LINEENABLEMUX1.9 (X0), SENSOR_LINE.1
unnamed: LINEENABLEMUX1.8 (X1), SENSOR_LINE.3
unnamed: LINEENABLEMUX1.7 (X2), SENSOR_LINE.5
unnamed: LINEENABLEMUX1.6 (X3), SENSOR_LINE.7
unnamed: LINEENABLEMUX1.5 (X4), SENSOR_LINE.11
unnamed: LINEENABLEMUX1.4 (X5), SENSOR_LINE.13
unnamed: LINEENABLEMUX1.3 (X6), SENSOR_LINE.15
unnamed: LINEENABLEMUX1.2 (X7), SENSOR_LINE.19
unnamed: LINEENABLEMUX1.23 (X8), SENSOR_LINE.21
unnamed: LINEENABLEMUX1.22 (X9), SENSOR_LINE.23
unnamed: LINEENABLEMUX1.21 (X10), SENSOR_LINE.25
unnamed: LINEVALUEMUX1.9 (X0), SENSOR_LINE.4
unnamed: LINEVALUEMUX1.8 (X1), SENSOR_LINE.6
unnamed: LINEVALUEMUX1.7 (X2), SENSOR_LINE.8
unnamed: LINEVALUEMUX1.6 (X3), SENSOR_LINE.10
unnamed: LINEVALUEMUX1.5 (X4), SENSOR_LINE.12
unnamed: LINEVALUEMUX1.4 (X5), SENSOR_LINE.14
unnamed: LINEVALUEMUX1.3 (X6), SENSOR_LINE.16
unnamed: LINEVALUEMUX1.2 (X7), SENSOR_LINE.18
unnamed: LINEVALUEMUX1.23 (X8), SENSOR_LINE.20
unnamed: LINEVALUEMUX1.22 (X9), SENSOR_LINE.22
unnamed: LINEVALUEMUX1.21 (X10), SENSOR_LINE.24
unnamed: ATMEGA1284P.35 (ADC5/PCINT5), SENSOR_DISTANCE_2.3
unnamed: ATMEGA1284P.12 (XTAL2), C12.2, Q1.2
unnamed: ATMEGA1284P.13 (XTAL1), C11.2, Q1.1
RESET: ATMEGA1284P.9 (RESET), JTAG_SEN.6; also elsewhere on the board
SCK: ATMEGA1284P.8 (SCK/OC3B/PCINT15); also elsewhere on the board
SS1: ATMEGA1284P.5 (SS/OC0B/PCINT12); also elsewhere on the board
VCC: ATMEGA1284P.10 (VCC), ATMEGA1284P.30 (AVCC), ATMEGA1284P.32 (AREF), C9.2, JTAG_SEN.4, LINEENABLEMUX1.1 (X), LINEENABLEMUX1.24 (VDD), LINEVALUEMUX1.24 (VDD), SENSOR_DISTANCE_1.2, SENSOR_DISTANCE_2.2; also elsewhere on the board

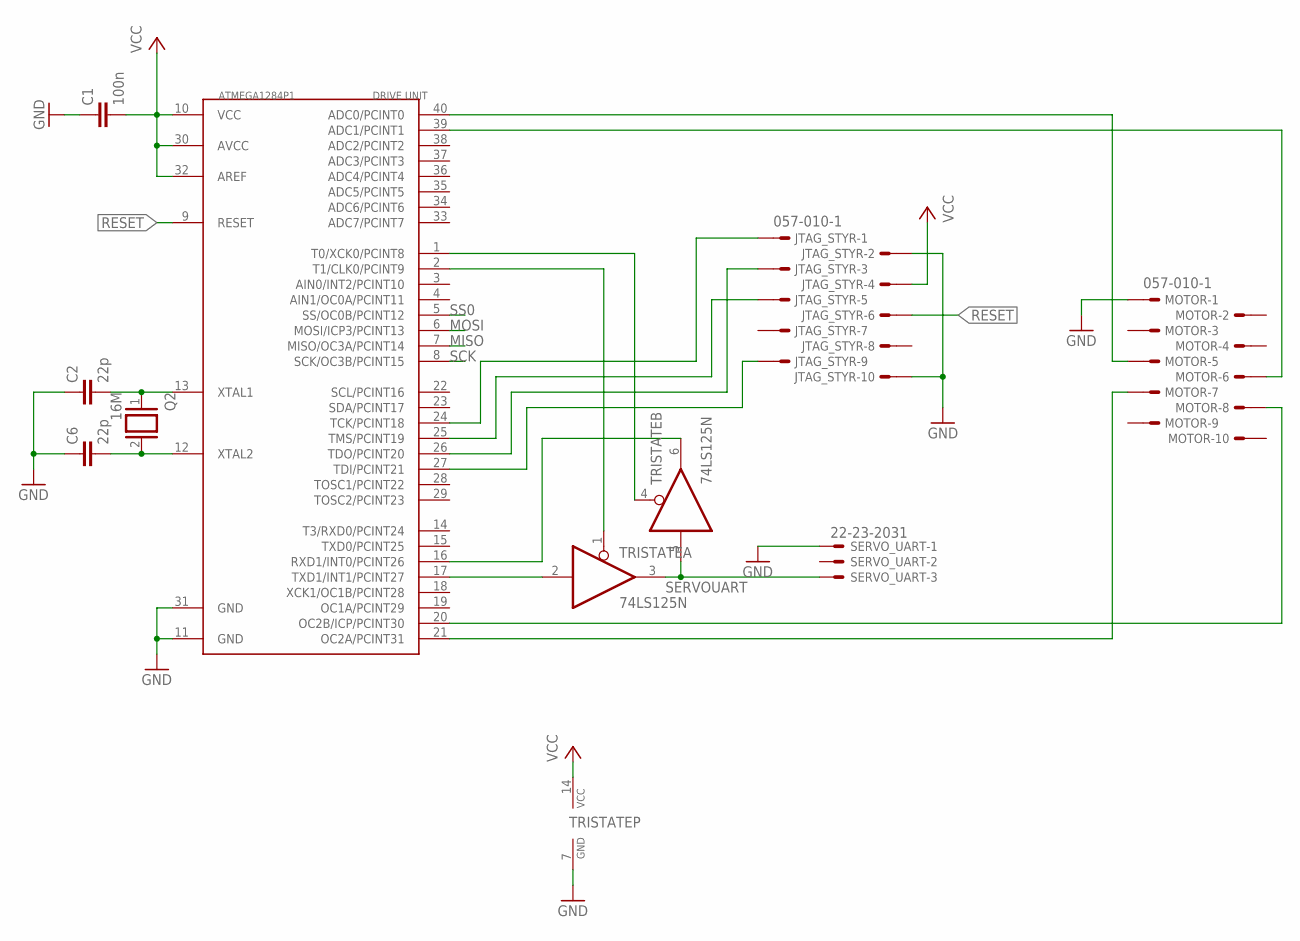
[picture p89: schematic gloria.sch, sheet 2, Styrenhet]

Parts:
ATMEGA1284P1: DRIVE UNIT; DIL40
C1: 100n; C025-024X044
C2, C6: 22p; C025-024X044
JTAG_STYR: 057-010-1
MOTOR: 057-010-1
Q2: 16M; QS
SERVO_UART: 22-23-2031
TRISTATE: 74LS125N; DIL14

Connections:
GND: ATMEGA1284P1.11 (GND), ATMEGA1284P1.31 (GND), C1.1, C2.1, C6.1, JTAG_STYR.2, JTAG_STYR.10, MOTOR.1, SERVO_UART.1, TRISTATE.7 (GND); also elsewhere on the board
MISO: ATMEGA1284P1.7 (MISO/OC3A/PCINT14); also elsewhere on the board
MOSI: ATMEGA1284P1.6 (MOSI/ICP3/PCINT13); also elsewhere on the board
unnamed: ATMEGA1284P1.24 (TCK/PCINT18), JTAG_STYR.1
unnamed: ATMEGA1284P1.27 (TDI/PCINT21), JTAG_STYR.9
unnamed: ATMEGA1284P1.26 (TDO/PCINT20), JTAG_STYR.3
unnamed: ATMEGA1284P1.25 (TMS/PCINT19), JTAG_STYR.5
unnamed: ATMEGA1284P1.21 (OC2A/PCINT31), MOTOR.7
unnamed: ATMEGA1284P1.40 (ADC0/PCINT0), MOTOR.5
unnamed: ATMEGA1284P1.39 (ADC1/PCINT1), MOTOR.6
unnamed: ATMEGA1284P1.20 (OC2B/ICP/PCINT30), MOTOR.8
unnamed: ATMEGA1284P1.12 (XTAL2), C6.2, Q2.2
unnamed: ATMEGA1284P1.13 (XTAL1), C2.2, Q2.1
RESET: ATMEGA1284P1.9 (RESET), JTAG_STYR.6; also elsewhere on the board
SCK: ATMEGA1284P1.8 (SCK/OC3B/PCINT15); also elsewhere on the board
SERVOUART: SERVO_UART.3, TRISTATE.3 (O), TRISTATE.5 (I)
SS0: ATMEGA1284P1.5 (SS/OC0B/PCINT12); also elsewhere on the board
STYR_UART_RX_E: ATMEGA1284P1.1 (T0/XCK0/PCINT8), TRISTATE.4 (OE)
STYR_UART_TX_E: ATMEGA1284P1.2 (T1/CLK0/PCINT9), TRISTATE.1 (OE)
UART1RX: ATMEGA1284P1.16 (RXD1/INT0/PCINT26), TRISTATE.6 (O)
UART1TX: ATMEGA1284P1.17 (TXD1/INT1/PCINT27), TRISTATE.2 (I)
VCC: ATMEGA1284P1.10 (VCC), ATMEGA1284P1.30 (AVCC), ATMEGA1284P1.32 (AREF), C1.2, JTAG_STYR.4, TRISTATE.14 (VCC); also elsewhere on the board

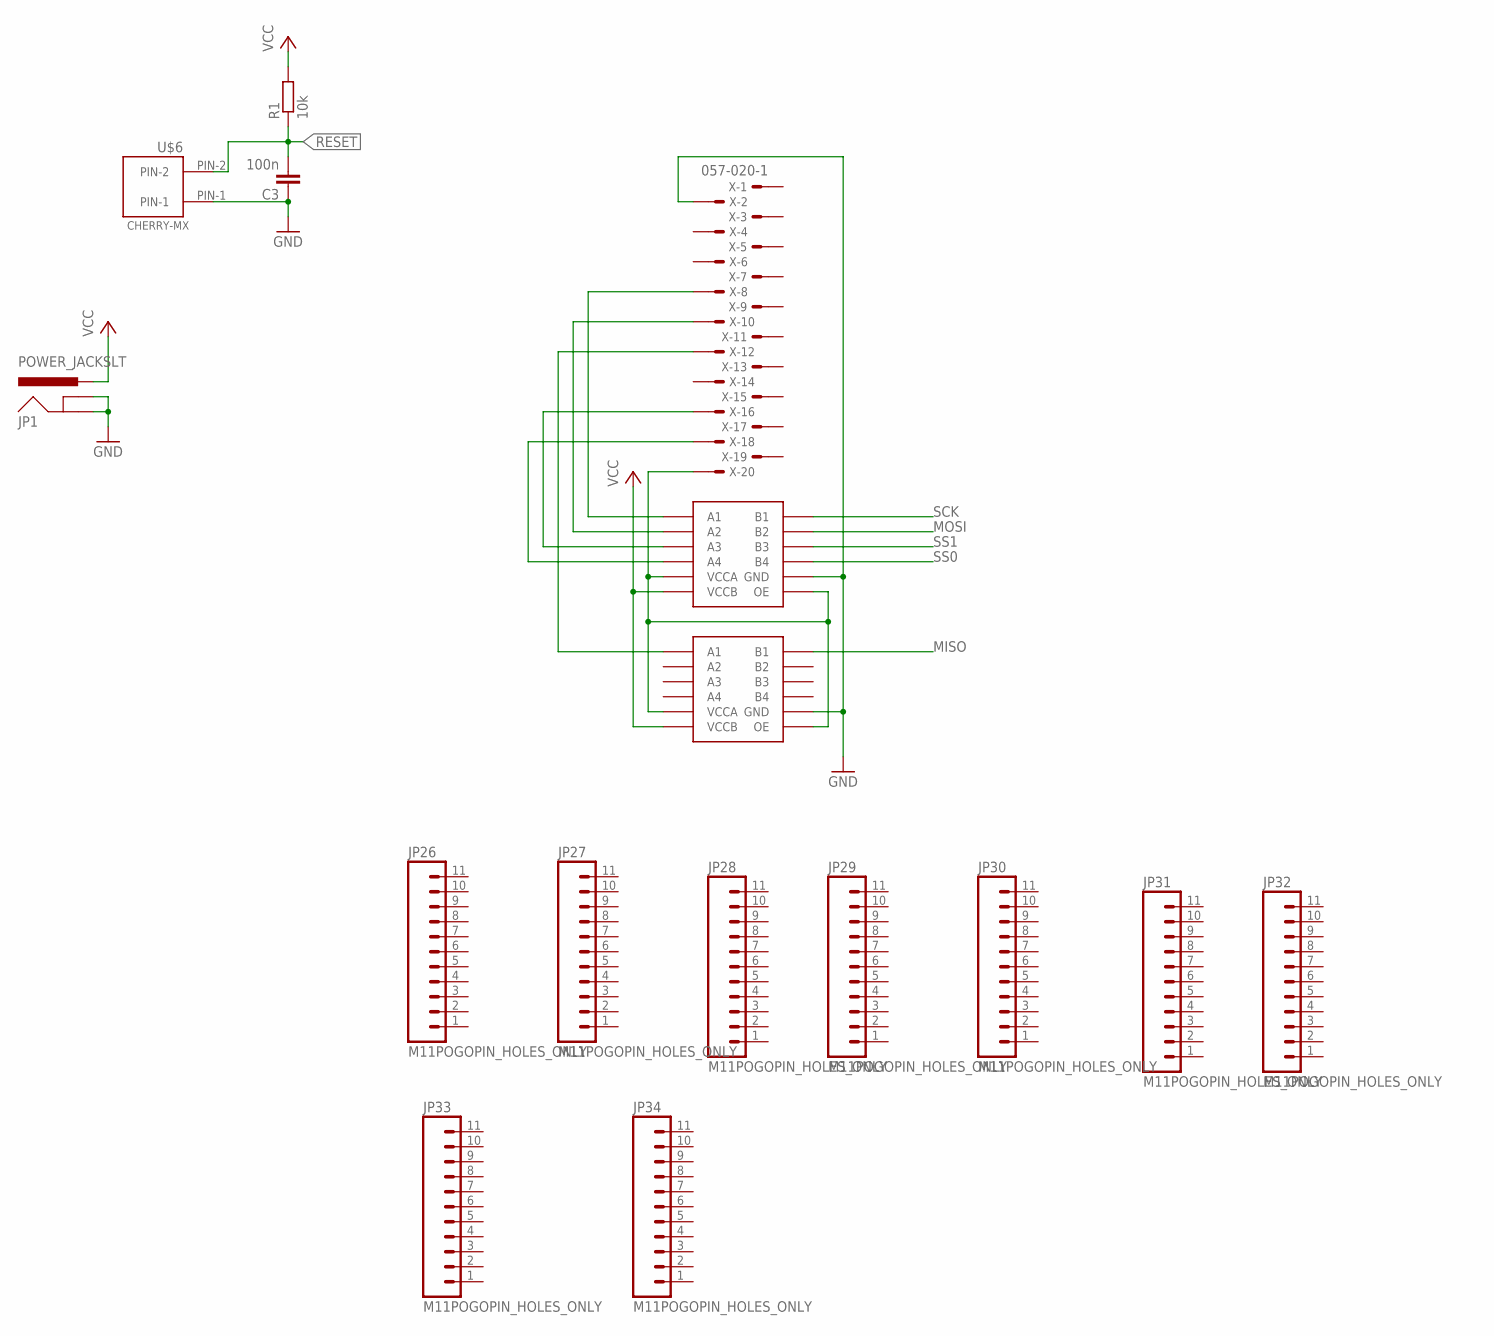
[picture p90: schematic gloria.sch, sheet 3, Allmänt]

Parts:
C3: 100n; C025-024X044
JP1: POWER_JACKSLT; POWER_JACK_SLOT
JP26, JP27, JP28, JP29, JP30, JP31, JP32, JP33, JP34: M11POGOPIN_HOLES_ONLY; 1X11_HOLES_ONLY
R1: 10k; 0204V
U$1, U$2: TXB0104SOIC(D); TXB0104
U$6: CHERRY-MX-I
X: 057-020-1

Connections:
GND: C3.1, JP1.GND@1 (GNDBREAK), JP1.GND@2 (GND), U$1.P$7 (GND), U$2.P$7 (GND), U$6.PIN-1, X.2; also elsewhere on the board
MISO: U$2.P$13 (B1); also elsewhere on the board
MOSI: U$1.P$12 (B2); also elsewhere on the board
unnamed: U$1.P$1 (VCCA), U$1.P$8 (OE), U$2.P$1 (VCCA), U$2.P$8 (OE), X.20
unnamed: U$1.P$2 (A1), X.8
unnamed: U$1.P$3 (A2), X.10
unnamed: U$2.P$2 (A1), X.12
unnamed: U$1.P$4 (A3), X.16
unnamed: U$1.P$5 (A4), X.18
RESET: C3.2, R1.1, U$6.PIN-2; also elsewhere on the board
SCK: U$1.P$13 (B1); also elsewhere on the board
SS0: U$1.P$10 (B4); also elsewhere on the board
SS1: U$1.P$11 (B3); also elsewhere on the board
VCC: JP1.PWR, R1.2, U$1.P$14 (VCCB), U$2.P$14 (VCCB); also elsewhere on the board

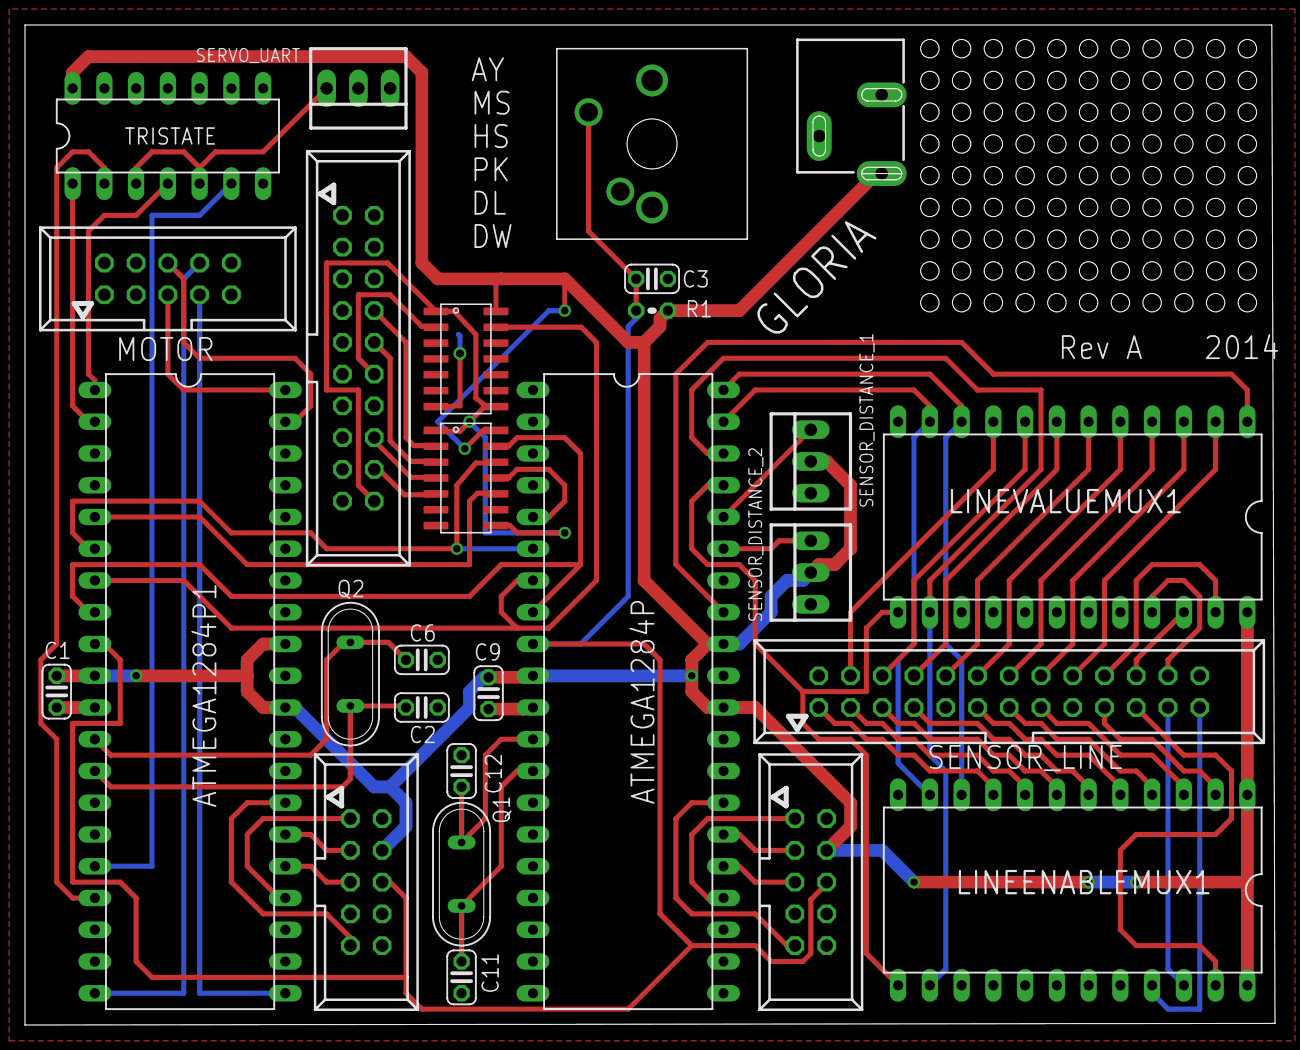
[picture p91: board gloria.brd from above]

Board: 2 copper layers, 100.0 x 80.0 mm, 36 parts (0 on the bottom side), 64 nets.
