ultralaserdeluxe/gloria/src/drive_unit/servo.c

/*
 * servo.c
 *
 * Created: 2014-11-08 17:53:04
 * Description: Functions for handling communication with a servo of 
 * 				type AX-12a
 */ 

#define F_CPU 16000000UL
#include <util/delay.h>
#include <util/atomic.h>
#include <stdbool.h>
#include <stddef.h>
#include <stdlib.h>
#include <avr/io.h>
#include "ax12a.h"
#include "usart.h"
#include "servo.h"
#include "parameter_chain.h"

/* Initialize servo */
void servo_init(int ID)
{
		// Set baud to clk/16 => 1Mbps */
		usart_init();
		usart_set_tx();
		servo_parameter_t *p = NULL;
		
		p = create_servo_parameter(P_RETURN_DELAY_TIME_INIT);
		add_servo_parameter_chain(p, P_CW_ANGLE_LIMIT_L_INIT);
		add_servo_parameter_chain(p, P_CW_ANGLE_LIMIT_H_INIT);
		add_servo_parameter_chain(p, P_CCW_ANGLE_LIMIT_L_INIT);
		add_servo_parameter_chain(p, P_CCW_ANGLE_LIMIT_H_INIT);

		send_servo_instruction(
			servo_instruction_packet(ID, INSTR_WRITE, P_RETURN_DELAY_TIME, p)
		);
		
		free_servo_parameter_chain(p);
		_delay_ms(1);
		
		p = create_servo_parameter(P_TORQUE_LIMIT_L_INIT);
		add_servo_parameter_chain(p, P_TORQUE_LIMIT_H_INIT);
		add_servo_parameter_chain(p, P_RETURN_LEVEL_INIT);
		add_servo_parameter_chain(p, P_ALARM_LED_INIT);
		add_servo_parameter_chain(p, P_ALARM_SHUTDOWN_INIT);
		
		send_servo_instruction(
			servo_instruction_packet(ID, INSTR_WRITE, P_MAX_TORQUE_L, p)
		);

		free_servo_parameter_chain(p);
		_delay_ms(1);
		
		p = create_servo_parameter(P_CW_COMPLIANCE_MARGIN_INIT);
		add_servo_parameter_chain(p, P_CCW_COMPLIANCE_MARGIN_INIT);
		add_servo_parameter_chain(p, P_CW_COMPLIANCE_SLOPE_INIT);
		add_servo_parameter_chain(p, P_CCW_COMPLIANCE_SLOPE_INIT);

		send_servo_instruction(
			servo_instruction_packet(ID, INSTR_WRITE, P_CW_COMPLIANCE_MARGIN_INIT, p)
		);
		
		free_servo_parameter_chain(p);
		_delay_ms(1);
		
		p = create_servo_parameter(P_TORQUE_ENABLE_INIT);

		send_servo_instruction(
			servo_instruction_packet(ID, INSTR_WRITE, P_TORQUE_ENABLE, p)
		);
		
		free_servo_parameter_chain(p);
		_delay_ms(1);
		
		p = create_servo_parameter(P_GOAL_SPEED_L_INIT);
		add_servo_parameter_chain(p, P_GOAL_SPEED_H_INIT);
		add_servo_parameter_chain(p, P_TORQUE_LIMIT_L_INIT);
		add_servo_parameter_chain(p, P_TORQUE_LIMIT_H_INIT);

		send_servo_instruction(
			servo_instruction_packet(ID, INSTR_WRITE, P_GOAL_SPEED_L, p)
		);
		
		free_servo_parameter_chain(p);
		_delay_ms(1);
		
		p = create_servo_parameter(P_PUNCH_L_INIT);
		add_servo_parameter_chain(p, P_PUNCH_H_INIT);
		send_servo_instruction(
			servo_instruction_packet(ID, INSTR_WRITE, P_PUNCH_L, p)
		);
		
		free_servo_parameter_chain(p);
}

/* Does the actual sending of data to servo over UART*/
void send_servo_instruction(servo_instruction_t *t)
{
	//ATOMIC_BLOCK(ATOMIC_RESTORESTATE)
	//{
		servo_parameter_t *current = get_servo_parameter(t);
		while (!empty_servo_parameter(current))
		{
			usart_transmit(current->current_parameter);
			current = current->next;
		}
		free_instruction_full(t);
	//}
}

/* Returns instruction for given parameters ready to be sent */
servo_instruction_t* servo_instruction_packet(int ID, int instr, int reg, servo_parameter_t *parameters)
{
	int length;
	if ((instr == INSTR_PING)||(instr == INSTR_ACTION)||(instr == INSTR_RESET))
	{
		length = 2; // 2 for instruction, checksum
	}
	else
	{
		length = servo_parameter_chain_length(parameters) + 3; // 3 for instruction, reg, checksum
	}
	servo_instruction_t *t = create_instruction();
	add_servo_parameter(t,0xFF);
	add_servo_parameter(t,0xFF);
	add_servo_parameter(t,ID);
	add_servo_parameter(t,length);
	add_servo_parameter(t,instr);
	if ((instr == INSTR_WRITE)||(instr == INSTR_REG_WRITE)||(instr == INSTR_READ))
	{
		add_servo_parameter(t,reg);
		servo_parameter_t *current = parameters;
		while (!empty_servo_parameter(current))
		{
			add_servo_parameter(t,servo_parameter_value(current));
			current = next_servo_parameter(current);
		}
	}
	add_servo_parameter(t,make_checksum(ID, length, instr, (reg + servo_parameter_sum(parameters))));
	return t;
}

/* Create checksum asked for from servo */
uint8_t make_checksum(uint8_t ID, uint8_t length, uint8_t instr, uint8_t parameters)
{
	return ~(ID + length + instr + parameters);
}

servo_instruction_t* create_instruction()
{ 
	servo_instruction_t *this = malloc(sizeof(servo_instruction_t));
	this->length = 0;
	this->first_parameter = NULL;
	this->last_parameter = NULL;
	return this;
}

servo_instruction_t* concatenate_instructions(servo_instruction_t *t1, servo_instruction_t *t2)
{
	t1->last_parameter->next = t2->first_parameter;
	t1->last_parameter = t2->last_parameter;
	free(t2);
	return t1;
}

void free_instruction(servo_instruction_t *t)
{
	free(t);
}

/* Free instruction and all parameters belonging to it */
void free_instruction_full(servo_instruction_t *t)
{
	//servo_parameter_t *current = t->first_parameter;
	free_servo_parameter_chain(t->first_parameter);
	//while(current != NULL)
	//{
	//	t->first_parameter = current->next;
	//	free(current);
	//	current = t->first_parameter;
	//}
	free_instruction(t);
}

/* Add parameter to arm instruction */
void add_servo_parameter(servo_instruction_t *instr, unsigned int new_parameter)
{
	if (empty_servo_parameter(instr->first_parameter))
	{
		instr->first_parameter = create_servo_parameter(new_parameter);
		instr->last_parameter = instr->first_parameter;
	}
	else
	{
		set_parameter_next(instr->last_parameter, create_servo_parameter(new_parameter));
		//instr->last_parameter->next = create_servo_parameter(new_parameter);
		instr->last_parameter = next_servo_parameter(instr->last_parameter);
		//instr->last_parameter = instr->last_parameter->next;
	}
	instr->length++;
}

servo_parameter_t* get_servo_parameter(servo_instruction_t *instr)
{
	return instr->first_parameter;
}
