ultralaserdeluxe/gloria/src/drive_unit/styrenhet.h

/*
 * styrenhet.h
 *
 * Created: 11/20/2014 7:11:49 PM
 *  Author: aleyn573
 */ 


#ifndef STYRENHET_H_
#define STYRENHET_H_

#include "command_queue.h"

command_queue_t *gloria_queue;

#endif /* STYRENHET_H_ */
