ultralaserdeluxe/gloria/(commit log)

2014-09-16 New track figure.
2014-09-23 edited motormodul
2014-09-29 Added tidsplan in Excel-format.
    [tidsplan_v0.4.xlsx]
2014-09-29 Systemskiss and tidsplan updated to v1.0
    [tidsplan_v1.0.xlsx]
2014-10-02 Changed version number.
    [tidsplan_v1.0.xlsx]
2014-10-02 Changed version number formatting.
    [tidsplan_v1.0.xlsx]
2014-10-07 Designspec-motormodul and protokoll updated
2014-10-07 Designspec-motormodul updated
2014-10-08 Designspec-protokoll updated, SPI instead of UART
2014-10-08 kopplingsschema initiated
    [main.sch]
2014-10-08 Added circuit diagram for the sensor unit.
    [sensorenhet.sch]
2014-10-08 Added circuit diagram for the arm/prop unit.
    [styrenhet.sch]
2014-10-09 Designspec updated
    [main.sch]
2014-10-09 changed flow-chart for interrupts on the motor-module
2014-10-10 Designspec-sensorenhet updated
2014-10-11 added code for the arm
2014-10-12 wrote about the arm
2014-10-13 Updated circuit diagrams.
    [sensorenhet.sch, styrenhet.sch]
2014-10-13 Added appendices with circuit diagrams.
2014-10-13 Shrinked the circuit diagram.
    [sensorenhet.sch]
2014-10-13 Added reference for update frequency = 25 Hz.
2014-10-27 Designspec updated to v0.2, except circuitdiagram
2014-10-28 Updated circuit diagram of sensor unit.
    [sensorenhet.sch]
2014-10-28 Updated circuit diagram for prop unit.
    [styrenhet.sch]
2014-10-29 Regulator stuff updated.
2014-10-29 constant speed in regulator
2014-10-29 detection works with normalized sensorvalues
2014-10-29 Improved regulator settings and changed sensorThread update freq.
2014-10-29 Smooth arm movements
2014-10-29 Changed regulator behaviour when on crossings or breaks.
2014-10-29 Integrated arm control.
2014-10-29 Added current error to shared stuff and fixed type of shared_stuff['regulator'].
2014-10-29 driveUnit can now handle float in motor speeds.
2014-10-29 Fixed regulator.
2014-11-01 added cad files
    [Base.ipt, Bicep.ipt, ForeArm.ipt, Gripper_Hand_Fixed.ipt, Guide_Rail_Fixed.ipt, PX-Gripper.iam, PX-Gripper.stp, Reactor_SOLID.iam]
2014-11-06 gitignore updated, initiated src styrenhet and sensorenhet
2014-11-06 Added a file for SPI functions.
2014-11-06 Created a simple echo test with SPI interrupts.
2014-11-09 Added ISR to spi functions.
2014-11-09 Sensorenhet now reads and stores values
2014-11-09 Implemented transmission for SPI slave, untested
2014-11-10 Testing PWM.
2014-11-11 kopplingsschema updated
    [gemensamt_avr.sch, sensorenhet.sch, styrenhet.sch]
2014-11-12 Sensorenhet updated w sensors on PORTA 4,5,7
2014-11-12 Working GUI for motor handling!
2014-11-13 Commented out all bogus code, re-doing threading part from scratch. Will take more time than intended to finish sadly.
2014-11-13 Improved performance sensorenhet
2014-11-13 able to send simple data to arm
2014-11-14 Added functions for motor control.
2014-11-14 Added functions for working with sensors.
2014-11-14 Updated sensor unit to use the new sensor functions.
2014-11-15 Restructured and updated styrenhet. SPI not implemented.
2014-11-16 Changed spi functions to not use the transmit queue.
2014-11-16 Fixed the ADC prescaler.
    [sensors.c]
2014-11-16 Added working spi recieve handler and updated main loop.
2014-11-17 new module for sensorreading
2014-11-18 changed sensorunit.py for the better
2014-11-18 wrote an arm class
2014-11-18 now i wrote an arm-class
2014-11-19 Styrenhet updated. Theres code to fix memoryleak (gets stuck in loop) and updated servo_init (still not working properly)
    [arm.c, ax12a.h, servo.c, spi.c, styrenhet.c]
2014-11-20 Added GUI input for ARM, working on autoarm/motor, also status/calibrate
2014-11-20 la till lite grejjer i driveunit å i maintraden
2014-11-20 new joystick class and a testprogram to controll motors with joystick
2014-11-21 Cleaned naming errors of modules, SPI module missing, where is it?
    [PCGUI.py]
2014-11-21 removed arm folder
2014-11-21 Added motor control.
2014-11-21 Fixed motor control.
2014-11-21 Motors functional. motor_action quickfixed
2014-11-22 fixed pcModule with package tail handling
    [pcModule.py]
2014-11-22 Updated circuit diagram.
    [gloria.sch]
2014-11-22 Removed old ciruit diagrams.
    [sensorenhet.sch, styrenhet.sch]
2014-11-23 Fixed a few input bugs resulting in nonexisting values
    [PCGUI.py]
2014-11-23 Keybinds operational. Working on a better implementation. Couple more input bug fixes.
    [PCGUI.py]
2014-11-23 Updated circuit diagrams some more.
    [gloria.sch]
2014-11-24 Routed board!
    [gloria.brd]
2014-11-25 Connected uninvoked pins.
    [gloria.brd, gloria.sch]
2014-11-25 Added some (possibly unnecessary) threadsafety for styrenhet
2014-11-25 A few bugfixes to speed input and variable change, hardcaped -100 <= speed <= 100
    [PCGUI.py]
2014-11-25 Optimized speed indicators, couple bugfixes to button usage, got rid of some duplicated code segments for keybindings
    [PCGUI.py]
2014-11-25 Added prototyping area.
    [gloria.brd, gloria.sch]
2014-11-26 Fixed motors initial velocity (untested)
    [command_queue.c, motor.c]
2014-11-27 Now reads from servii, motor init speed verified
2014-11-27 regulator to regulate
2014-11-27 recover lost sensorthread file
2014-11-27 a test for the regulator
2014-11-27 Code now exists for reading servo status (untested)
2014-11-28 improved regulator
2014-11-28 Rerouted board manually.
    [gloria.brd, gloria.sch]
2014-11-29 Removed acceleration from motor
2014-11-29 created a new regulator
2014-12-01 Fixed a memoryleak. Theres still a timing-error (i think) somewhere
    [arm.c, command_queue.c, servo.c, servo.h, styrenhet.c, usart.c, usart.h]
2014-12-02 Everything is done in interrupt. Needs testing
2014-12-02 Replaced old version of GUI with new for testing
    [PCGUI.py]
2014-12-02 Extracted parameter_chain from servo
2014-12-02 tuned regulator
2014-12-02 Started rebuilding regulator.
2014-12-02 Moved new regulator to suitable place.
2014-12-02 Cleaning repo: Replaced old PCGUI with correct one
    [PCGUI.py]
2014-12-02 Moved arm.py to suitable place.
2014-12-02 Renamed sensorenhet.
2014-12-02 Deleted old regulator.
2014-12-02 Removed old test file and renamed regulatorNew.
2014-12-02 Added a decode and fixed a minor error.
    [pcModule.py]
2014-12-02 Made regulator keep track of update periods.
2014-12-03 For got about SPI in gitignore
2014-12-03 Changed to old regulator class but changed position calculations.
2014-12-03 A couple of minor changes to connect.sh to make it more readable
2014-12-04 Fixed PWM, can now run at much slower speed
    [motor.c]
2014-12-05 remade arm module
2014-12-05 added comment about arm limits in pcModule
2014-12-05 edited arm
2014-12-05 Changed sensorList to a dictionary.
2014-12-06 mainThread now uses dictionary instead of sensorList.
2014-12-06 Renamed regulatorNew -> regulator.
2014-12-07 Added IP argument (no error checking) to PCGUI
    [PCGUI.py]
2014-12-08 Massive layout changes. Added support for status in the GUI. A few tweaks on layout of previous buttons.
2014-12-08 Adde BOM.
    [gloria_bom.xls]
2014-12-09 Small value display fixes
    [PCGUI.py]
2014-12-09 Usart interrupt-driven, servo status updated only on command. Might still crash on status-command
    [arm.c, command_queue.c, styrenhet.c, usart.c]
2014-12-11 Sensorunit updated to work with additional line sensors
2014-12-11 Fixed bug with wrong address in case
    [sensor_unit.c, sensors.c]
2014-12-12 Changed sensorThreads access to calibration data.
2014-12-12 Added calibration functionality.
2014-12-12 Added calibrate functionality.
2014-12-13 Fixed order of distance sensors.
2014-12-13 Added calibration and normalization of middle sensors.
2014-12-13 Added sensor evaluation functions.
2014-12-13 modified regulator, works somewhat better
2014-12-13 changed regulator and added filtered value for distance sensors NOT TESTED
2014-12-13 fixed issue that connection did not brake sometimes when bb went down
    [pcModule.py]
2014-12-13 removed print
2014-12-13 Renamed sensor_eval
2014-12-14 Grahics added to sensor and styr
2014-12-15 removed raise socket error in pcmodule
    [pcModule.py]
2014-12-15 Last fixes to fonts, removed todo:s, subsectionized styrning, corrected gripklo-steering (ONLY missing up/down now), added figure to Gui.png
2014-12-15 Renames, edits to steering manual, added short intro. One bug with pagebreak after Styrning, appendix refuses to pagebreak?
2014-12-15 updated kopplingsschema
    [gloria.sch]
2014-12-15 Added 3rd subsection for styr (calibrate), added short about AVR, finalized picture, fixed some unnecessary pagebreaks
2014-12-15 Fixed a seriously annoying bug.
    [sensors.h]
2014-12-15 Fixed bug in sensorunit
    [sensors.h]
2014-12-15 Updated with finished GUI picture, did a few spellchecks, removed auto arm description and replaced with no package
2014-12-16 Added flush timer to mainthread
2014-12-16 Fixed regulator in tekdok
2014-12-16 arm doesn not ignore command, even if out of bounds
2014-12-16 fixed some rounding off erros
    [Gui.py]
2014-12-16 arm controls just sends increase in position
2014-12-16 Changed steer arm to use speed instead of position.
2014-12-16 Hacker shields on full power.
2014-12-17 fixed gui arm joystick
    [Gui.py]
2014-12-17 Corrected graph for sensorvalues
2014-12-17 Added calibrat.
2014-12-17 fixed some with the new sensordistance values
    [Gui.py]
2014-12-17 Better arm positions
2014-12-17 More fitting delays in fixed arm positions
